rapha-gz-UC3M/Brazo_Robotico/README.md

# Brazo_Robotico
This is a repository for the fabrication of a Robotic Arm
