rapha-gz-UC3M/Brazo_Robotico/Gripper_Rapha/piezas_mm/README.md

# Piezas de Vasil y de Ignacio en mm

Copia exacta de `Arm_Vasil/Brazo_modificado_STL/*.stl` y `Base_Ignacio/*.stl` pasada a **mm**. Los originales
están en pulgadas (lo que exporta Solid Edge por defecto); aquí están multiplicados por 25,4. Tienen el mismo
nombre, la misma geometría y las mismas coordenadas, sin girar ni modificar nada.

Sirven para abrirlos, medirlos o montarlos en cualquier programa sin tener que escalar.
**Para imprimir, usa `imprimir_brazo/`**: ahí las piezas ya están orientadas y con los cambios necesarios.

Se regeneran con `python scripts/preparar_impresion.py` (por ejemplo, si Vasil o Ignacio cambian una pieza).
