rapha-gz-UC3M/Brazo_Robotico/Gripper_Rapha/base_sup_imprimible/montada.png

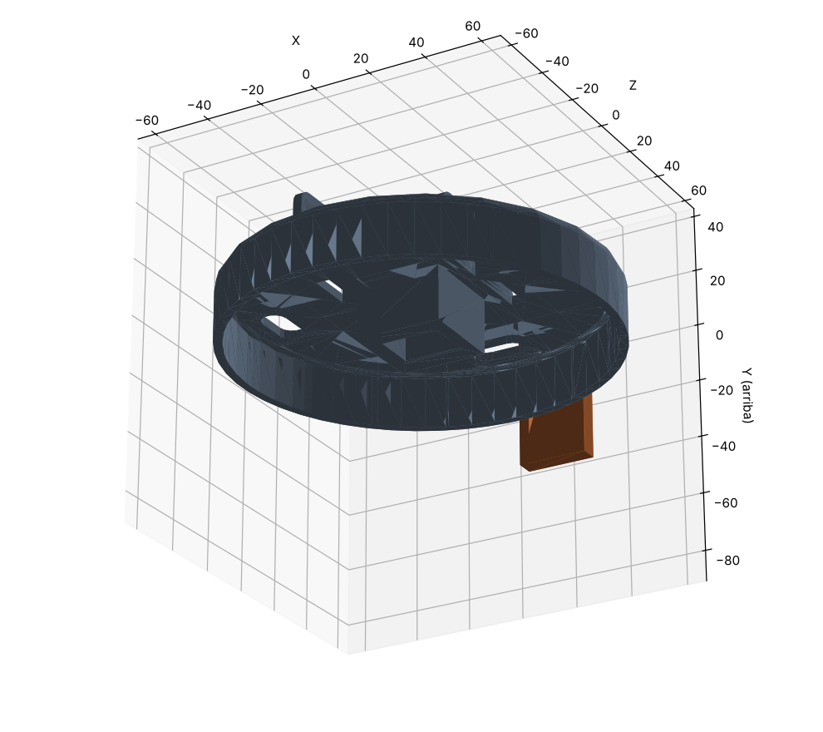
Gripper_Rapha/base_sup_imprimible/montada.png
