rapha-gz-UC3M/Brazo_Robotico/Gripper_Rapha/GRIPPER/imagenes/acople_punta_vistas.png

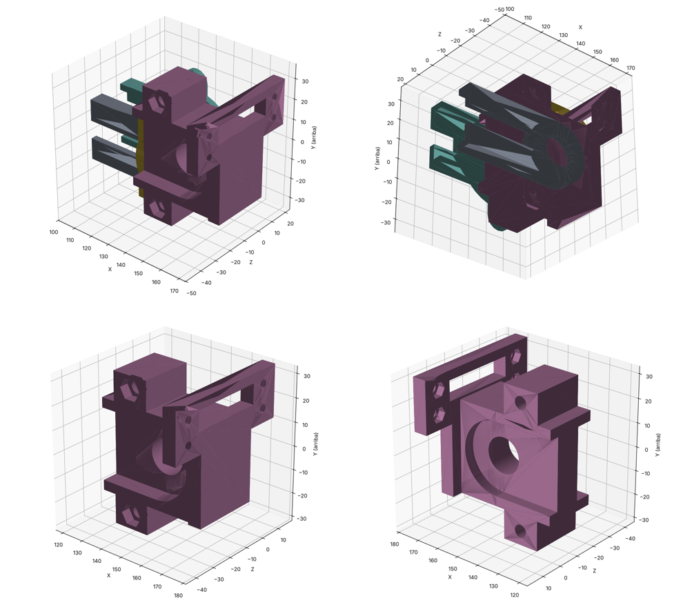
Gripper_Rapha/GRIPPER/imagenes/acople_punta_vistas.png
