rapha-gz-UC3M/Brazo_Robotico/Gripper_Rapha/imagenes/union_punta_detalle.png

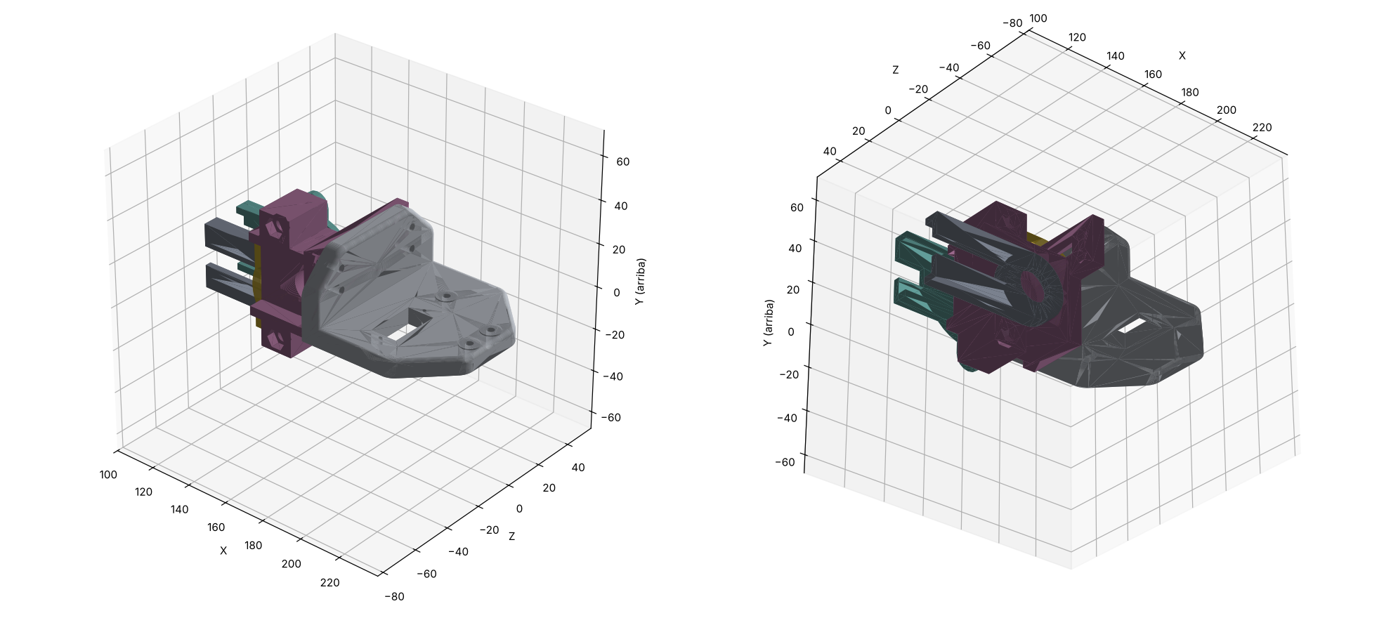
Gripper_Rapha/imagenes/union_punta_detalle.png
