rapha-gz-UC3M/Brazo_Robotico/Gripper_Rapha/comprobacion/ASM_gear_right.stl

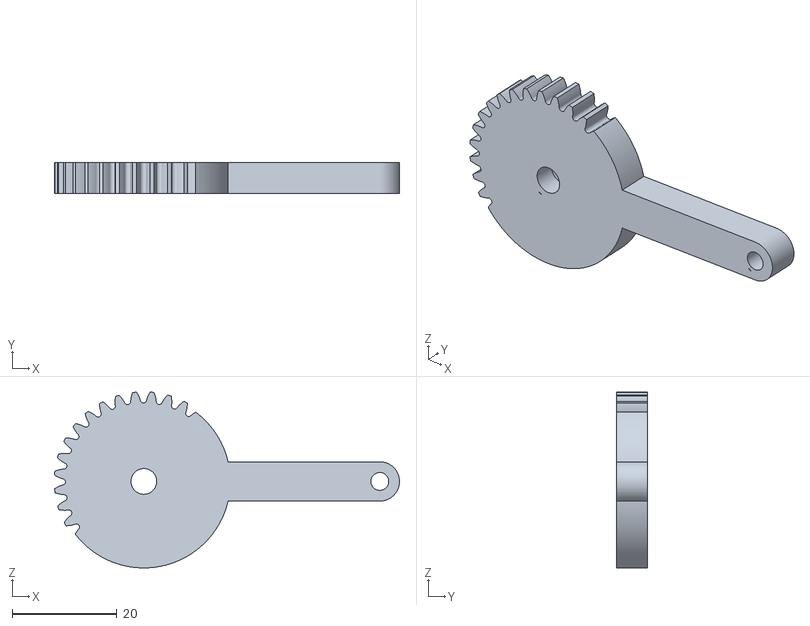
[picture p10: CAD file, 2026-10-21]
Gripper_Rapha/comprobacion/ASM_gear_right.stl
65.8 x 6.00 x 33.5
