rapha-gz-UC3M/Brazo_Robotico/Gripper_Rapha/Ensamblaje Garra - Chapa 3 agujeros.STL

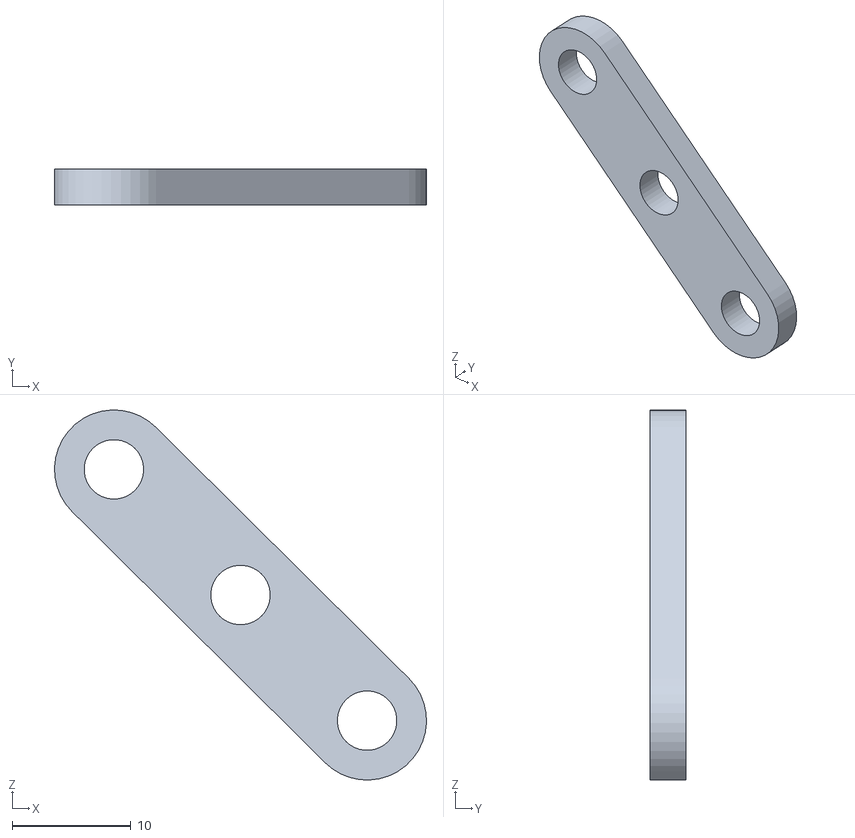
[picture p11: CAD file, 2026-10-06]
Gripper_Rapha/Ensamblaje Garra - Chapa 3 agujeros.STL
31.3 x 3.00 x 31.1
