rapha-gz-UC3M/Brazo_Robotico/Gripper_Rapha/ENSAMBLAJE/ensamblaje_brazo.stl

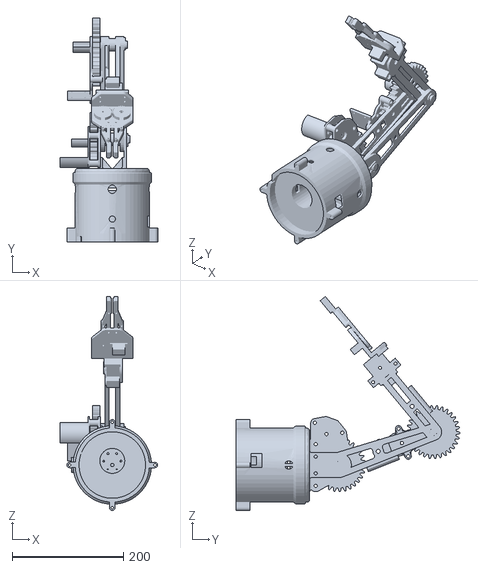
[picture p12: CAD file, 2026-10-24]
Gripper_Rapha/ENSAMBLAJE/ensamblaje_brazo.stl
175.3 x 402.9 x 384.7
