rapha-gz-UC3M/Brazo_Robotico/Gripper_Rapha/GRIPPER/comprobacion/ASM_arm_right.stl

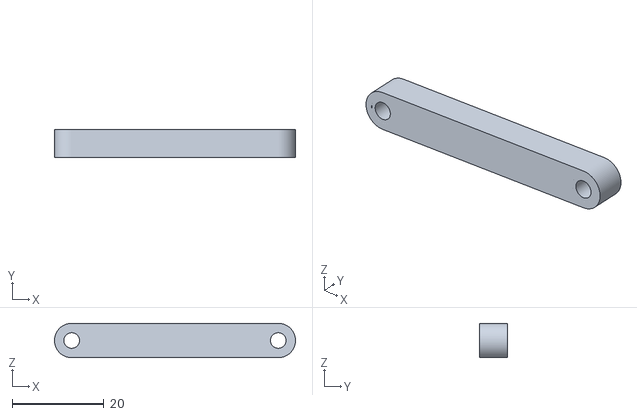
[picture p13: CAD file, 2026-10-24]
Gripper_Rapha/GRIPPER/comprobacion/ASM_arm_right.stl
52.5 x 6.00 x 7.50
