rapha-gz-UC3M/Brazo_Robotico/Gripper_Rapha/GRIPPER/solid_edge/Ensamblaje_Gripper_Brazo_Vasil/Ensamblaje_Gripper_Brazo_Vasil_x1.5.step

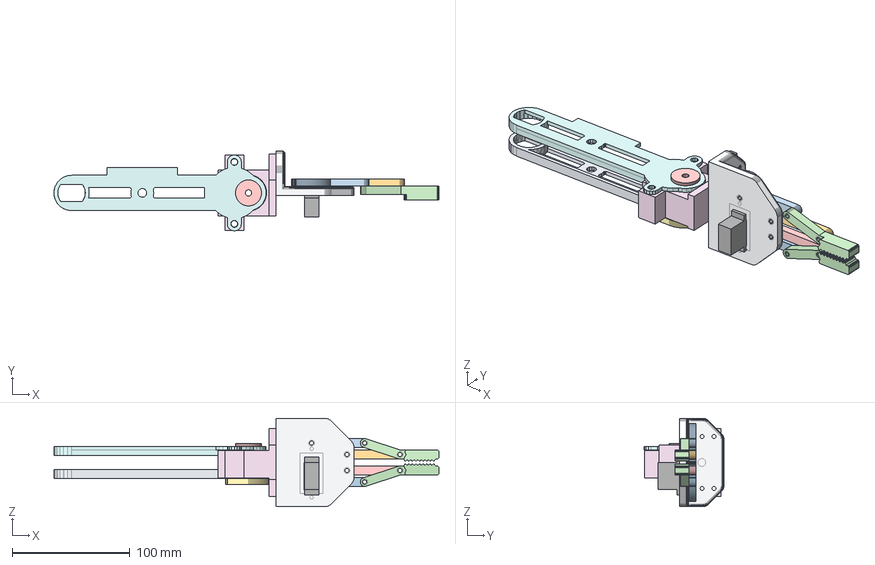
[picture p14: CAD file, 2026-10-24]
Gripper_Rapha/GRIPPER/solid_edge/Ensamblaje_Gripper_Brazo_Vasil/Ensamblaje_Gripper_Brazo_Vasil_x1.5.step
326.4 x 67.8 x 75.0 mm
Brazo_Parte_2_1_Vasil
Brazo_Parte_2.2_4_Vasil
Acople_punta_vasil_x1.5
Contraplaca_acople_x1.5
Casquillo_punta_x1.5
Gripper_base_plate_x1.5
Gripper_gear_left_x1.5
Gripper_gear_right_x1.5
Gripper_arm_left_x1.5
Gripper_arm_right_x1.5
Gripper_jaw_left_x1.5
Gripper_jaw_right_x1.5
Servo_MG90S_referencia
