rapha-gz-UC3M/Brazo_Robotico/Gripper_Rapha/solid_edge/Ensamblaje_Gripper_Antebrazo_Vasil_x1.5_STEP/Ensamblaje_Gripper_Antebrazo_Vasil_x1.5.step

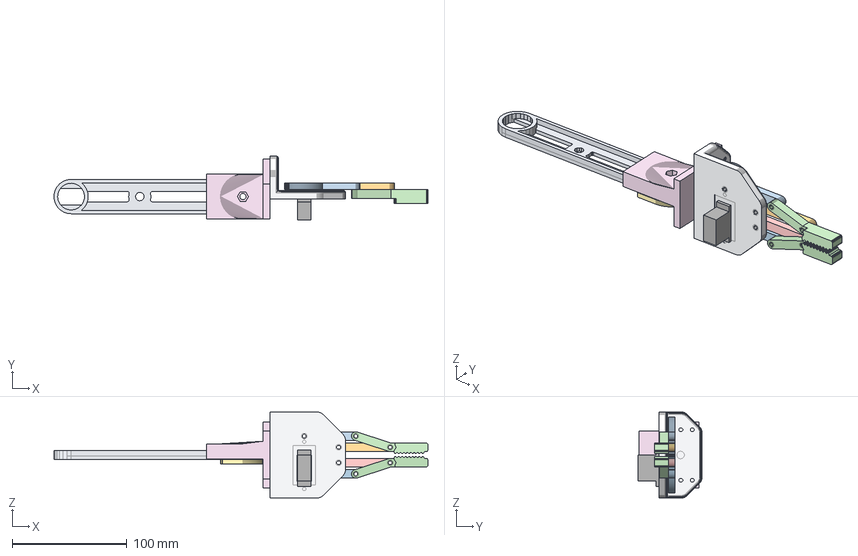
[picture p15: CAD file, 2026-10-20]
Gripper_Rapha/solid_edge/Ensamblaje_Gripper_Antebrazo_Vasil_x1.5_STEP/Ensamblaje_Gripper_Antebrazo_Vasil_x1.5.step
326.4 x 56.0 x 75.0 mm
REF_Brazo_Parte_2_1_Vasil
Acople_punta_vasil_x1.5
Contraplaca_acople_x1.5
Gripper_base_plate_x1.5
Gripper_gear_left_x1.5
Gripper_gear_right_x1.5
Gripper_arm_left_x1.5
Gripper_arm_right_x1.5
Gripper_jaw_left_x1.5
Gripper_jaw_right_x1.5
Servo_MG90S_referencia
