rapha-gz-UC3M/Brazo_Robotico/Gripper_Rapha/comprobacion/ASM_contraplaca_acople.stl

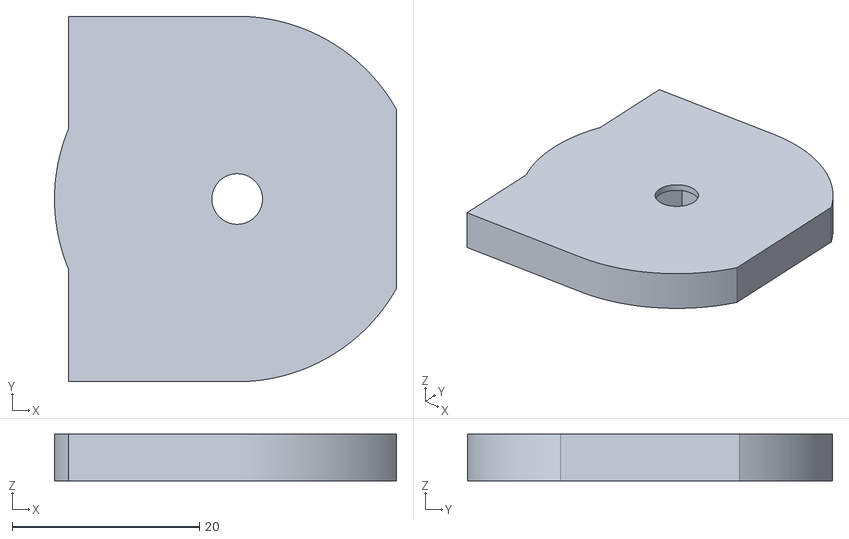
[picture p16: CAD file, 2026-10-21]
Gripper_Rapha/comprobacion/ASM_contraplaca_acople.stl
36.5 x 39.0 x 5.00
