rapha-gz-UC3M/Brazo_Robotico/Gripper_Rapha/Ensamblaje Garra - Chapa 2 agujeros.STL

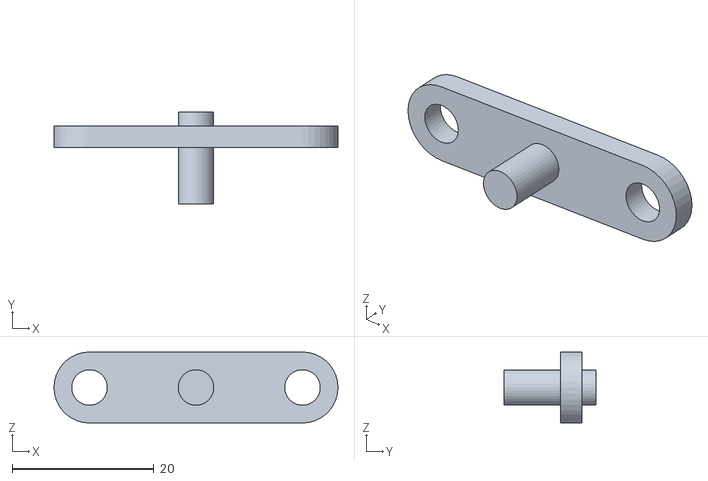
[picture p17: CAD file, 2026-10-06]
Gripper_Rapha/Ensamblaje Garra - Chapa 2 agujeros.STL
40.0 x 13.0 x 10.0
