rapha-gz-UC3M/Brazo_Robotico/Gripper_Rapha/ensamblaje_completo/ensamblaje_completo.stl

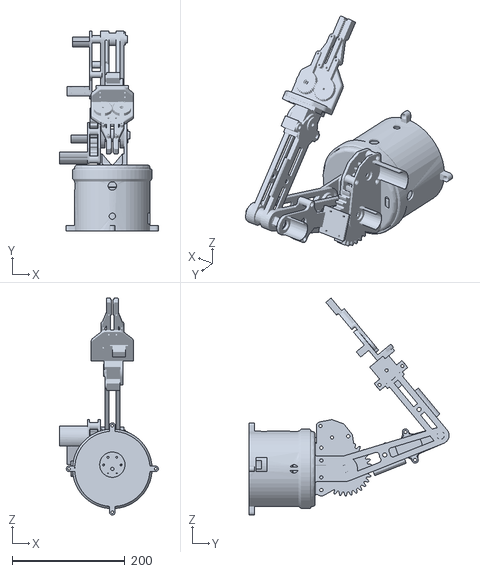
[picture p18: CAD file, 2026-10-21]
Gripper_Rapha/ensamblaje_completo/ensamblaje_completo.stl
175.3 x 354.9 x 384.7
