rapha-gz-UC3M/Brazo_Robotico/Gripper_Rapha/GRIPPER/comprobacion/ASM_casquillo_punta.stl

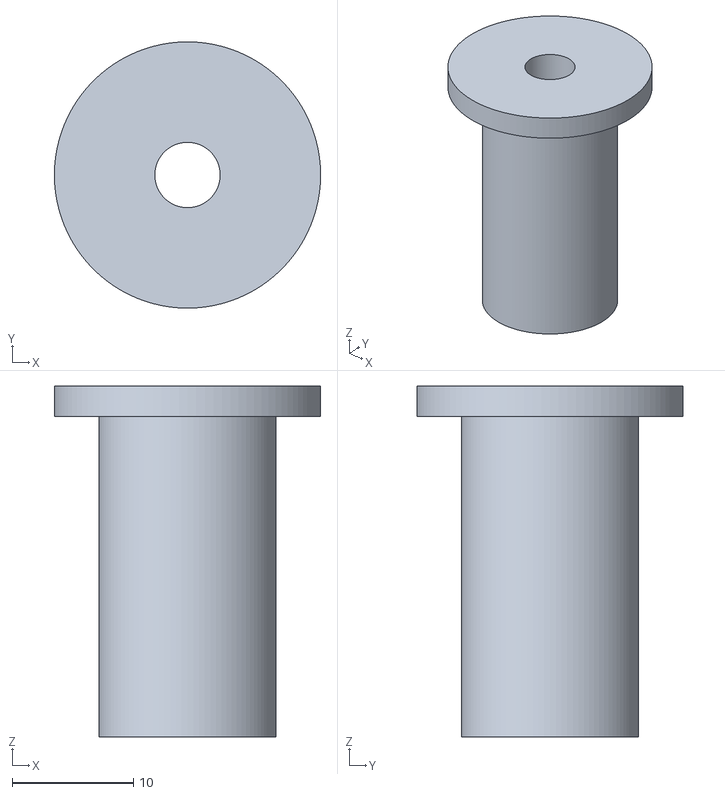
[picture p19: CAD file, 2026-10-24]
Gripper_Rapha/GRIPPER/comprobacion/ASM_casquillo_punta.stl
22.0 x 22.0 x 29.0
