rapha-gz-UC3M/Brazo_Robotico/Gripper_Rapha/Ensamblaje Garra - Cuerpo.STL

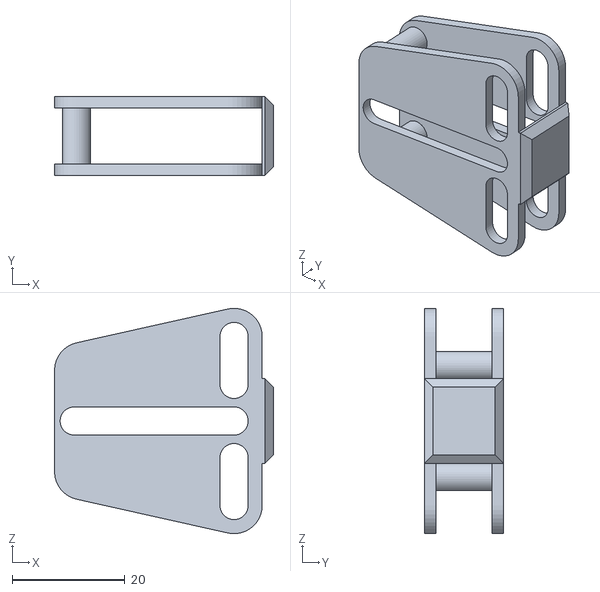
[picture p20: CAD file, 2026-10-06]
Gripper_Rapha/Ensamblaje Garra - Cuerpo.STL
38.9 x 14.0 x 40.0
