rapha-gz-UC3M/Brazo_Robotico/Gripper_Rapha/GRIPPER/comprobacion/ASM_servo_MG90S_aprox.stl

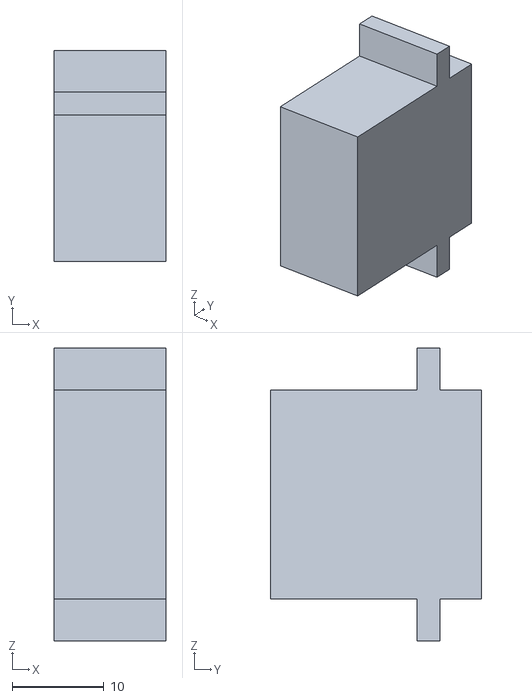
[picture p21: CAD file, 2026-10-24]
Gripper_Rapha/GRIPPER/comprobacion/ASM_servo_MG90S_aprox.stl
12.2 x 23.0 x 32.0
