rapha-gz-UC3M/Brazo_Robotico/Gripper_Rapha/comprobacion/ASM_jaw_right.stl

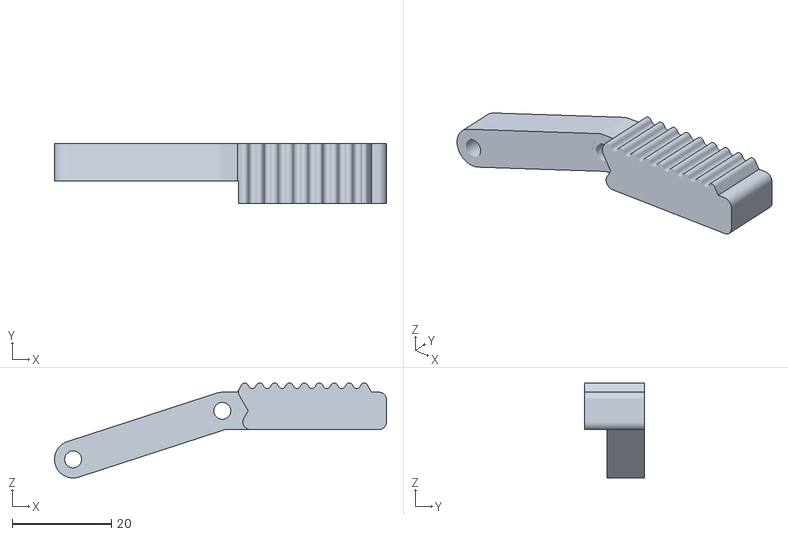
[picture p22: CAD file, 2026-10-21]
Gripper_Rapha/comprobacion/ASM_jaw_right.stl
66.7 x 12.0 x 19.1
