rapha-gz-UC3M/Brazo_Robotico/Gripper_Rapha/Ensamblaje Garra - Pinza.STL

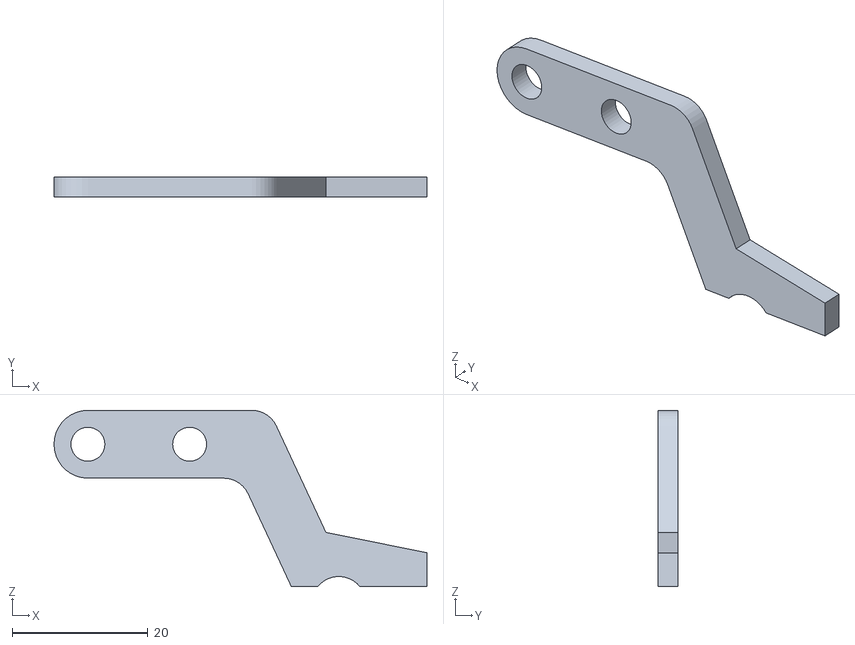
[picture p23: CAD file, 2026-10-06]
Gripper_Rapha/Ensamblaje Garra - Pinza.STL
55.0 x 3.00 x 26.0
