rapha-gz-UC3M/Brazo_Robotico/Gripper_Rapha/comprobacion/ASM_base_plate.stl

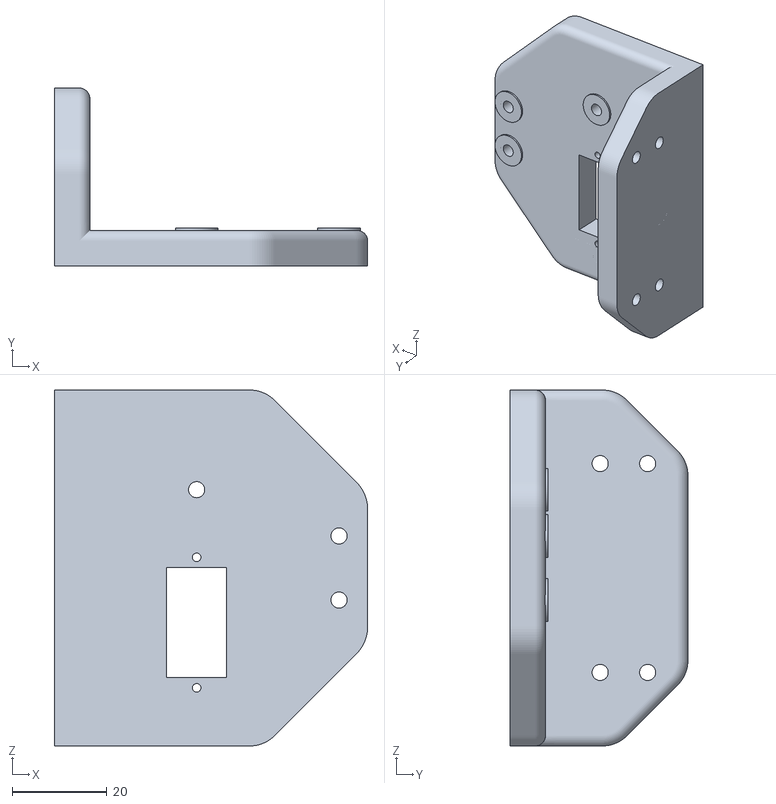
[picture p24: CAD file, 2026-10-21]
Gripper_Rapha/comprobacion/ASM_base_plate.stl
66.0 x 37.5 x 75.0
