rapha-gz-UC3M/Brazo_Robotico/Gripper_Rapha/GRIPPER/comprobacion/ASM_acople_punta_vasil.stl

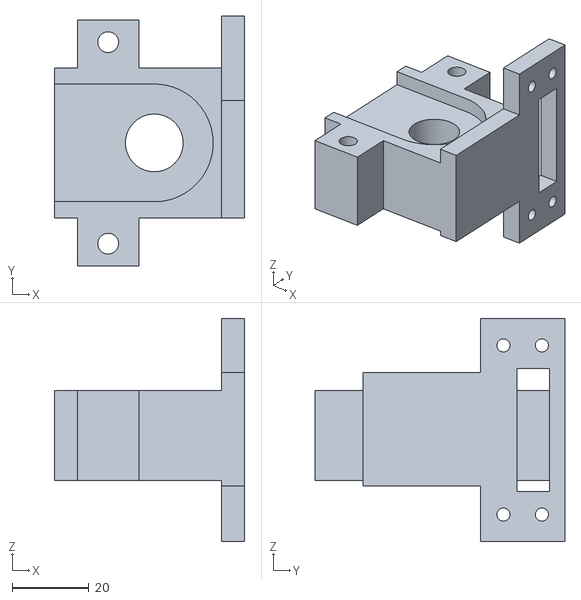
[picture p25: CAD file, 2026-10-24]
Gripper_Rapha/GRIPPER/comprobacion/ASM_acople_punta_vasil.stl
49.5 x 65.0 x 58.0
