rapha-gz-UC3M/Brazo_Robotico/Arm_Vasil/Brazo_modificado_STL/Brazo Parte 2.2_4.stl

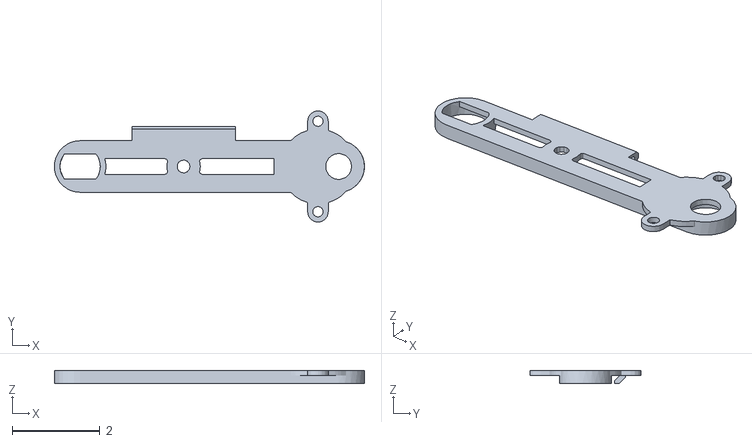
[picture p26: CAD file, 2026-10-21]
Arm_Vasil/Brazo_modificado_STL/Brazo Parte 2.2_4.stl
7.08 x 2.54 x 0.295
