rapha-gz-UC3M/Brazo_Robotico/Base_Ignacio/BASE_TAPA_INF.stl

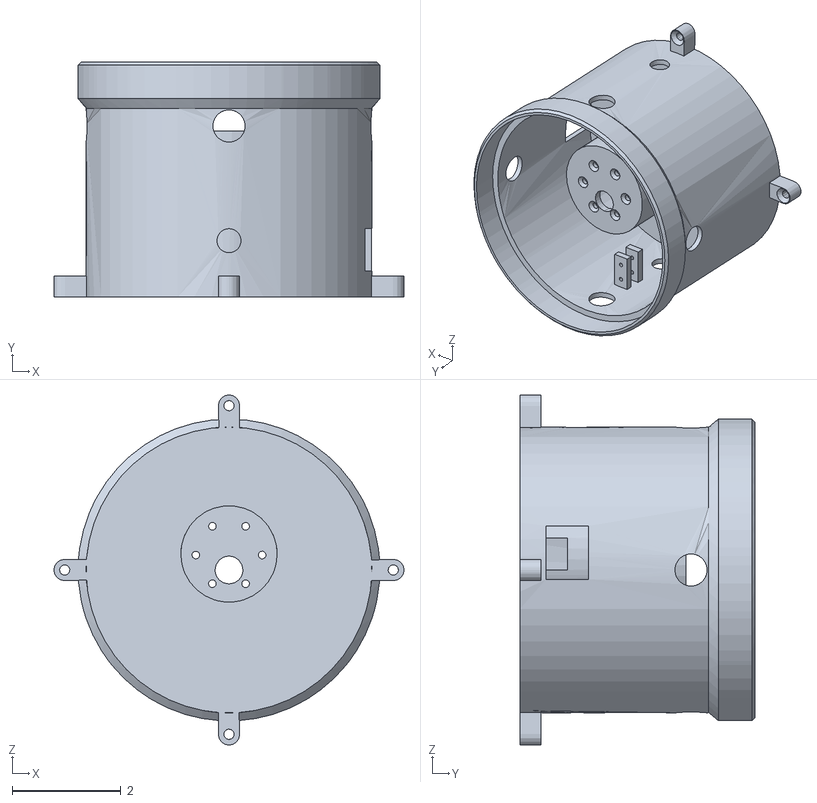
[picture p27: CAD file, 2026-10-17]
Base_Ignacio/BASE_TAPA_INF.stl
6.44 x 4.33 x 6.44
