rapha-gz-UC3M/Brazo_Robotico/Base_Igni/BR3E - Base Tapa Inferior.STL

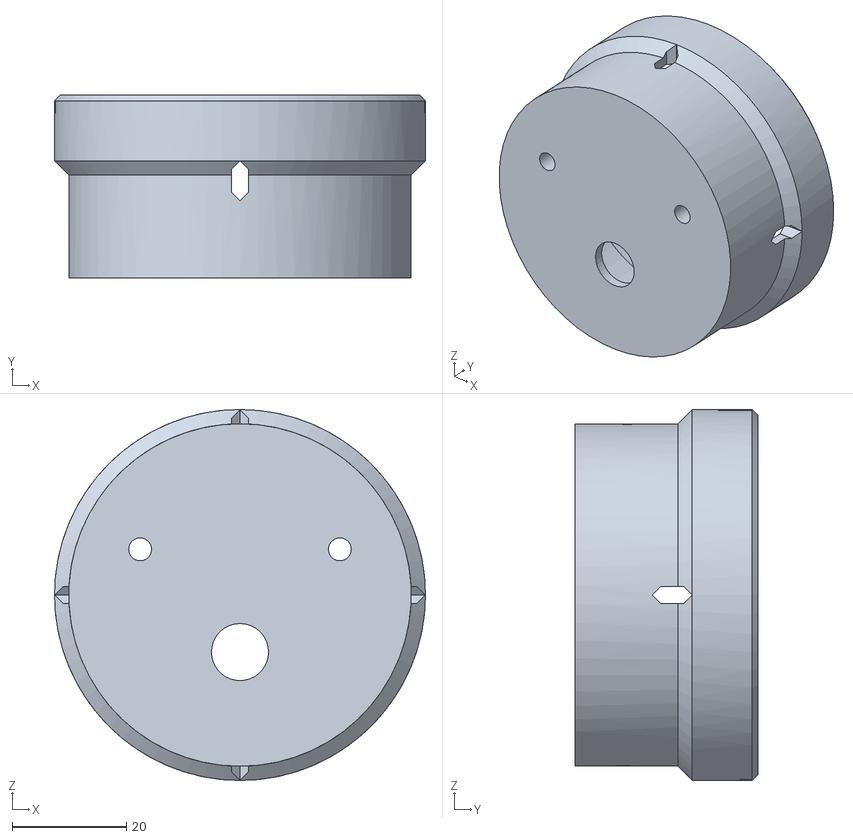
[picture p28: CAD file, 2026-10-06]
Base_Igni/BR3E - Base Tapa Inferior.STL
65.0 x 32.0 x 65.0
