rapha-gz-UC3M/Brazo_Robotico/Brazo_Vasil/BR3E - Sujetador de eje.STL

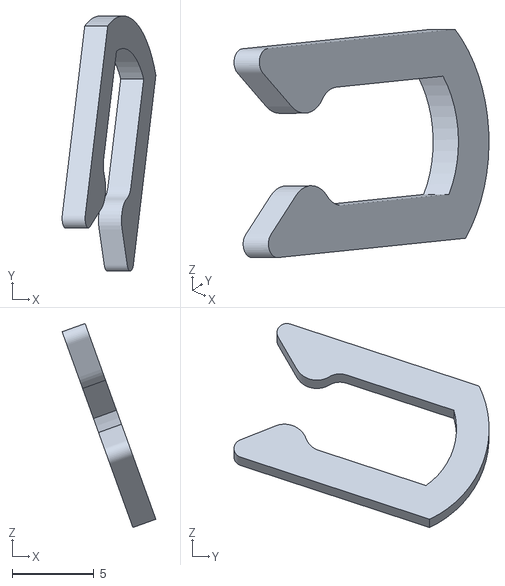
[picture p29: CAD file, 2026-10-06]
Brazo_Vasil/BR3E - Sujetador de eje.STL
5.75 x 15.6 x 12.5
