rapha-gz-UC3M/Brazo_Robotico/Gripper_Rapha/base_sup_imprimible/BASE_TAPA_SUP_pestana.stl

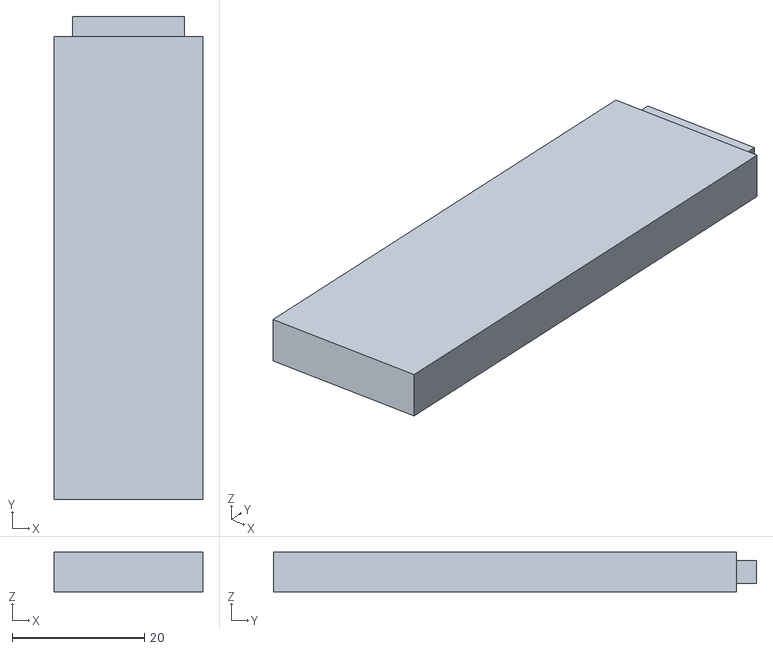
[picture p30: CAD file, 2026-10-21]
Gripper_Rapha/base_sup_imprimible/BASE_TAPA_SUP_pestana.stl
22.5 x 73.0 x 6.00
