rapha-gz-UC3M/Brazo_Robotico/Gripper_Rapha/ENSAMBLAJE/piezas_colocadas/Brazo_Parte_1_1.stl

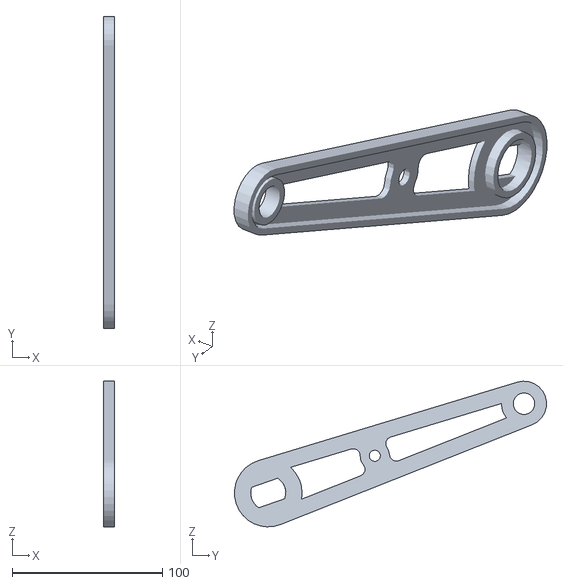
[picture p31: CAD file, 2026-10-24]
Gripper_Rapha/ENSAMBLAJE/piezas_colocadas/Brazo_Parte_1_1.stl
7.50 x 207.3 x 96.8
