rapha-gz-UC3M/Brazo_Robotico/Gripper_Rapha/ensamblaje_completo/motores_JGB37_referencia.stl

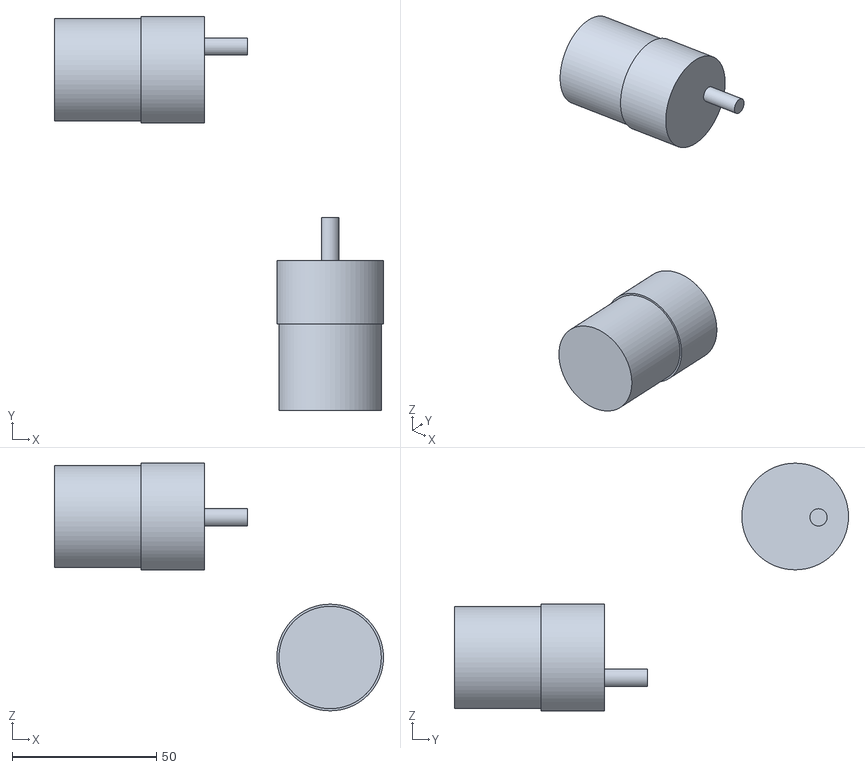
[picture p32: CAD file, 2026-10-21]
Gripper_Rapha/ensamblaje_completo/motores_JGB37_referencia.stl
114.1 x 136.7 x 85.9
