rapha-gz-UC3M/Brazo_Robotico/Gripper_Rapha/ensamblaje_completo/piezas_colocadas/Vasil_Pinon_hombro.stl

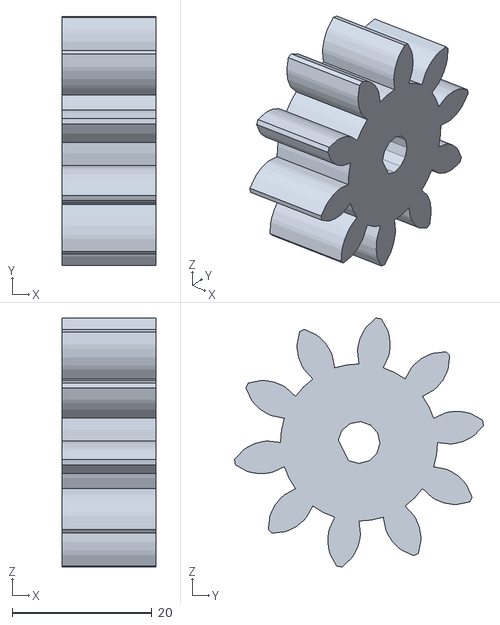
[picture p33: CAD file, 2026-10-21]
Gripper_Rapha/ensamblaje_completo/piezas_colocadas/Vasil_Pinon_hombro.stl
13.5 x 35.7 x 35.7
