rapha-gz-UC3M/Brazo_Robotico/Gripper_Rapha/GRIPPER/original/gripper_superbtech/base_plate.stl

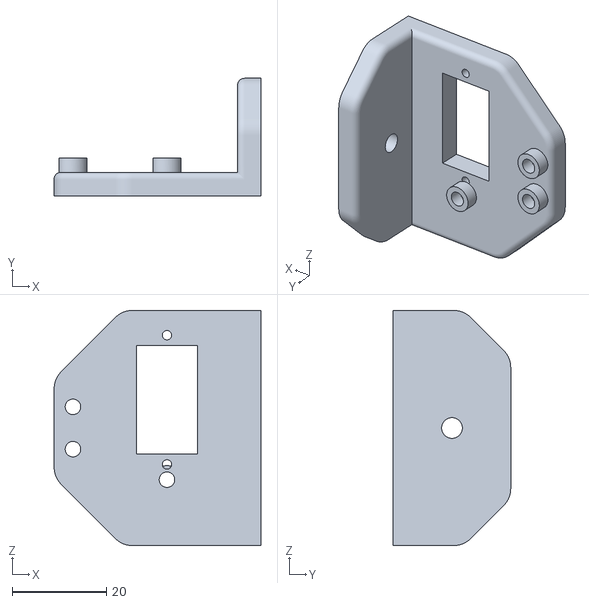
[picture p34: CAD file, 2026-10-24]
Gripper_Rapha/GRIPPER/original/gripper_superbtech/base_plate.stl
44.0 x 25.0 x 50.0
