rapha-gz-UC3M/Brazo_Robotico/Gripper_Rapha/IMPRIMIR/1_base/Pieza_Eje_Giro_Base.stl

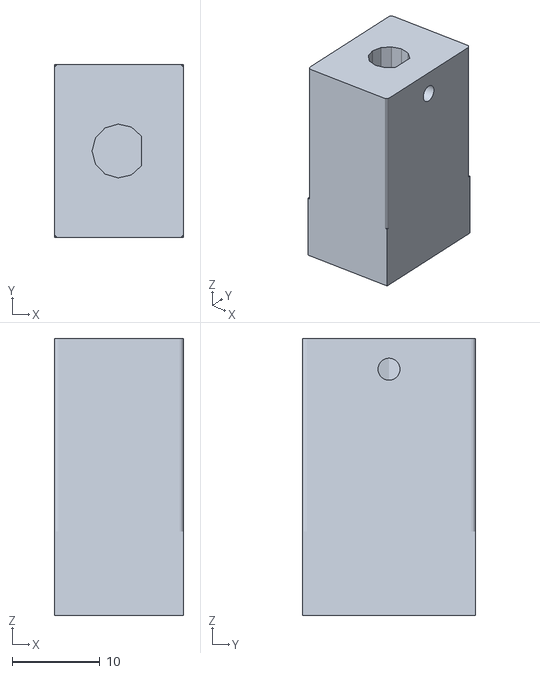
[picture p35: CAD file, 2026-10-24]
Gripper_Rapha/IMPRIMIR/1_base/Pieza_Eje_Giro_Base.stl
14.8 x 19.8 x 31.6
