rapha-gz-UC3M/Brazo_Robotico/Gripper_Rapha/IMPRIMIR/2_brazo/Sujetador_de_eje_x2.stl

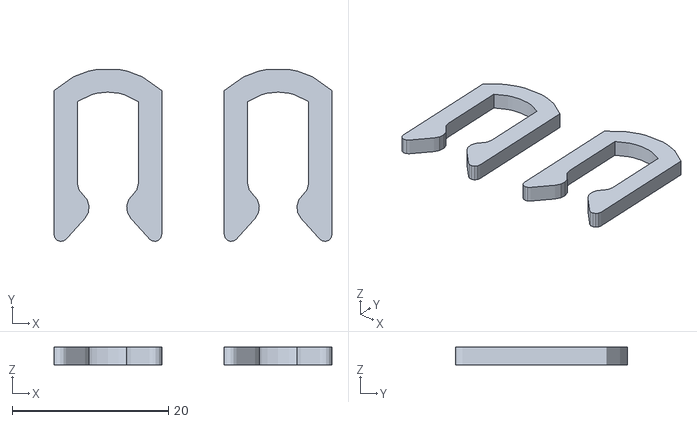
[picture p36: CAD file, 2026-10-24]
Gripper_Rapha/IMPRIMIR/2_brazo/Sujetador_de_eje_x2.stl
35.6 x 22.0 x 2.25
