rapha-gz-UC3M/Brazo_Robotico/Gripper_Rapha/imprimir_brazo/2_brazo_Vasil/Shield_2_imprimible.stl

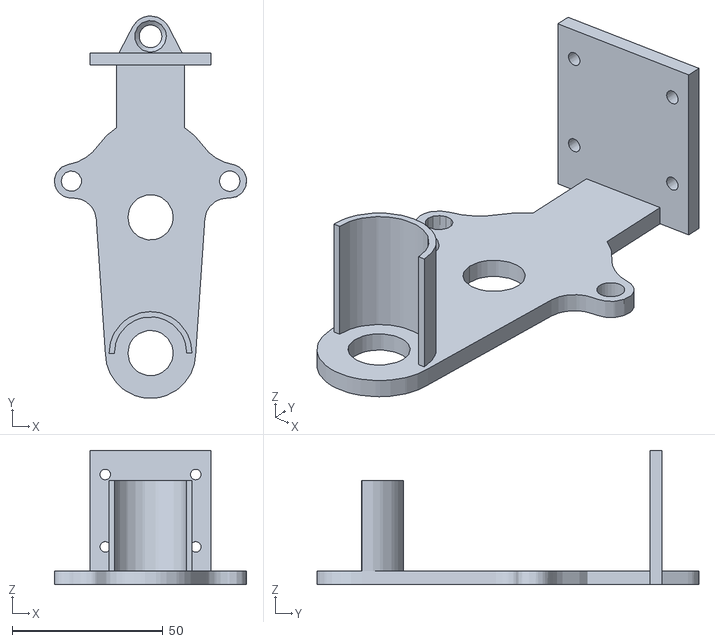
[picture p37: CAD file, 2026-10-21]
Gripper_Rapha/imprimir_brazo/2_brazo_Vasil/Shield_2_imprimible.stl
63.7 x 126.6 x 44.5
