rapha-gz-UC3M/Brazo_Robotico/Gripper_Rapha/original/gripper_superbtech/jaw_left.stl

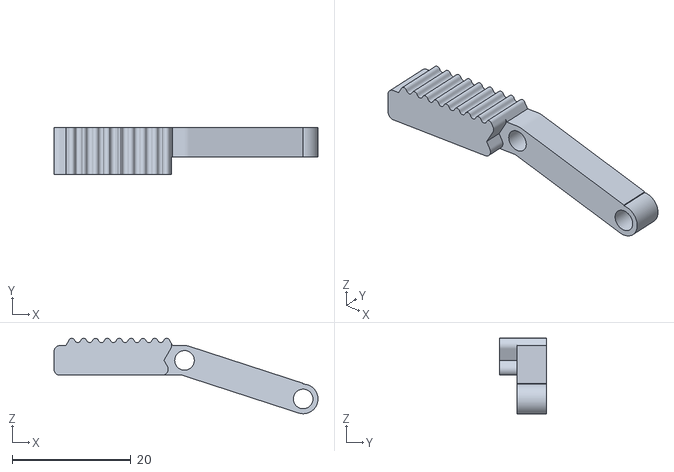
[picture p38: CAD file, 2026-10-18]
Gripper_Rapha/original/gripper_superbtech/jaw_left.stl
44.5 x 8.00 x 12.7
