rapha-gz-UC3M/Brazo_Robotico/Gripper_Rapha/piezas_mm/Arm_Vasil/Shield 1 - 2.0_1.stl

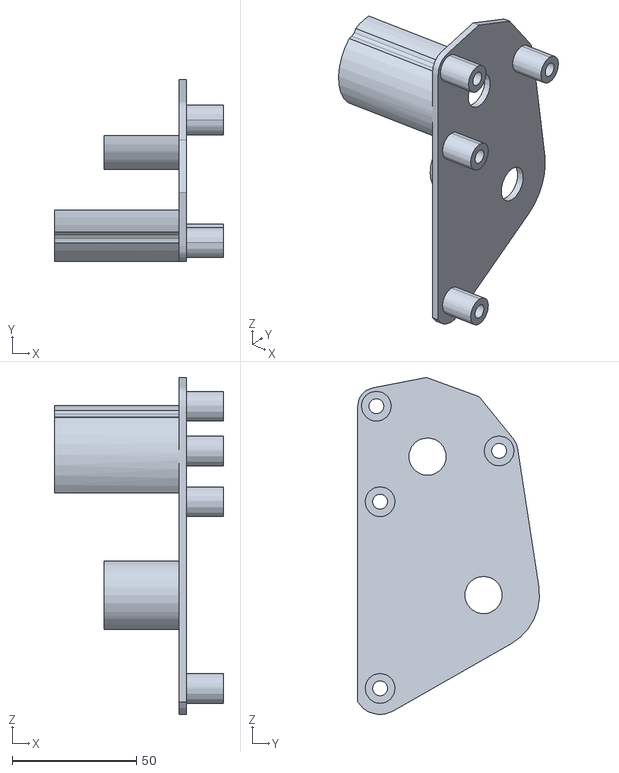
[picture p39: CAD file, 2026-10-21]
Gripper_Rapha/piezas_mm/Arm_Vasil/Shield 1 - 2.0_1.stl
68.0 x 73.1 x 135.4
