rapha-gz-UC3M/Brazo_Robotico/Gripper_Rapha/piezas_mm/Base_Ignacio/BASE_TAPA_SUP.stl

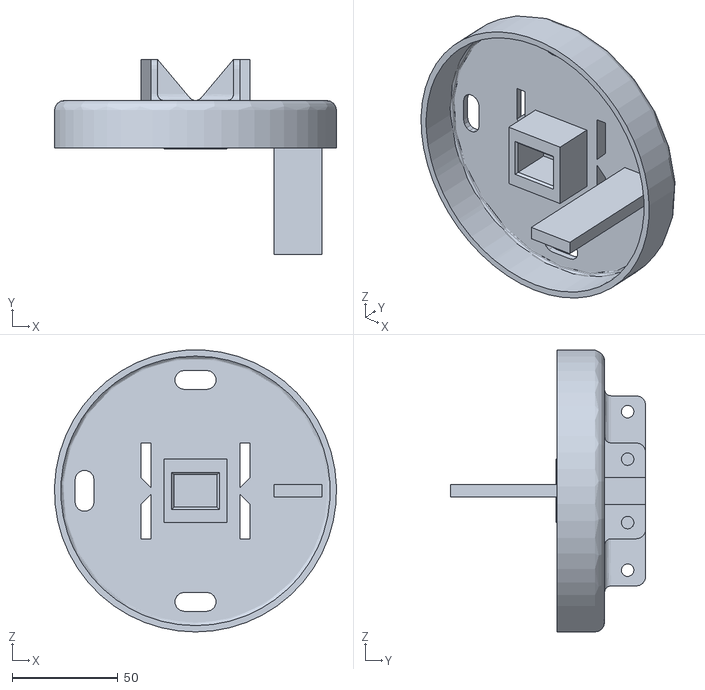
[picture p40: CAD file, 2026-10-21]
Gripper_Rapha/piezas_mm/Base_Ignacio/BASE_TAPA_SUP.stl
133.4 x 92.5 x 133.4
