rapha-gz-UC3M/Brazo_Robotico/Gripper_Rapha/shields_imprimibles/comprobacion/Shield_1_placa_posicion_montaje.stl

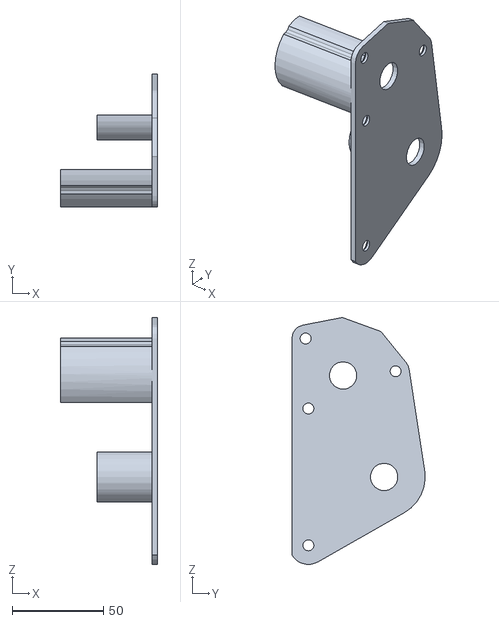
[picture p41: CAD file, 2026-10-21]
Gripper_Rapha/shields_imprimibles/comprobacion/Shield_1_placa_posicion_montaje.stl
53.0 x 73.1 x 135.4
