rapha-gz-UC3M/Brazo_Robotico/Gripper_Rapha/shields_imprimibles/Shield_2_separadores_x3.stl

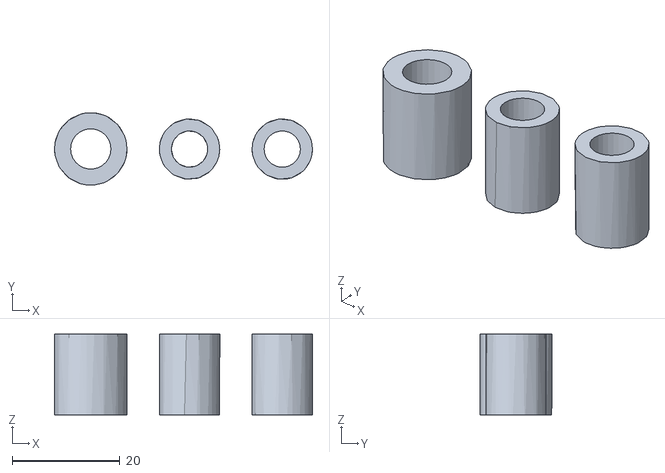
[picture p42: CAD file, 2026-10-21]
Gripper_Rapha/shields_imprimibles/Shield_2_separadores_x3.stl
48.0 x 13.5 x 15.0
