rapha-gz-UC3M/Brazo_Robotico/Arm_Vasil/Brazo_modificado_STL/Shield 1 - 2.0_1.stl

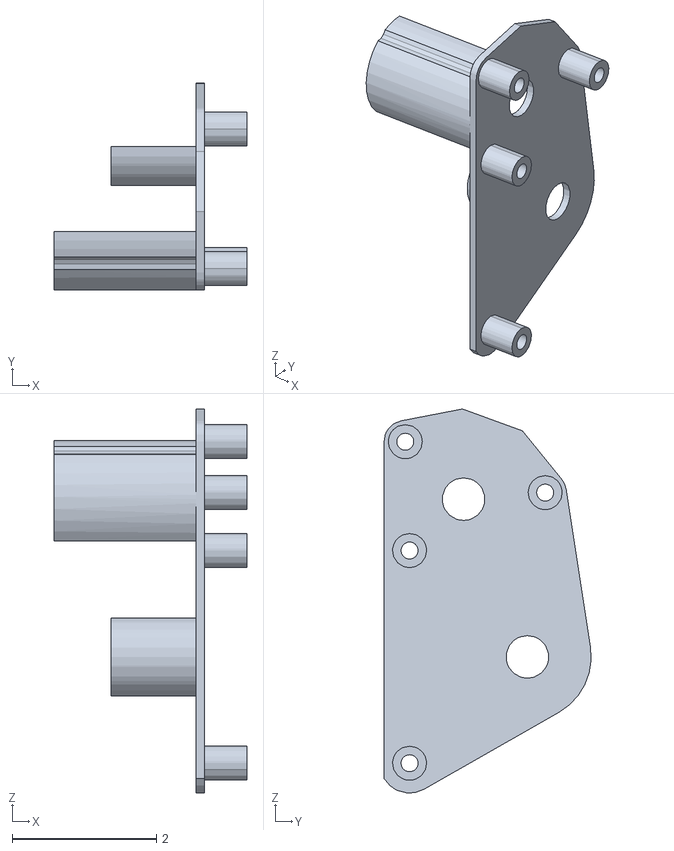
[picture p43: CAD file, 2026-10-21]
Arm_Vasil/Brazo_modificado_STL/Shield 1 - 2.0_1.stl
2.68 x 2.88 x 5.33
