rapha-gz-UC3M/Brazo_Robotico/Base_Ignacio/BASE_TAPA_SUP.stl

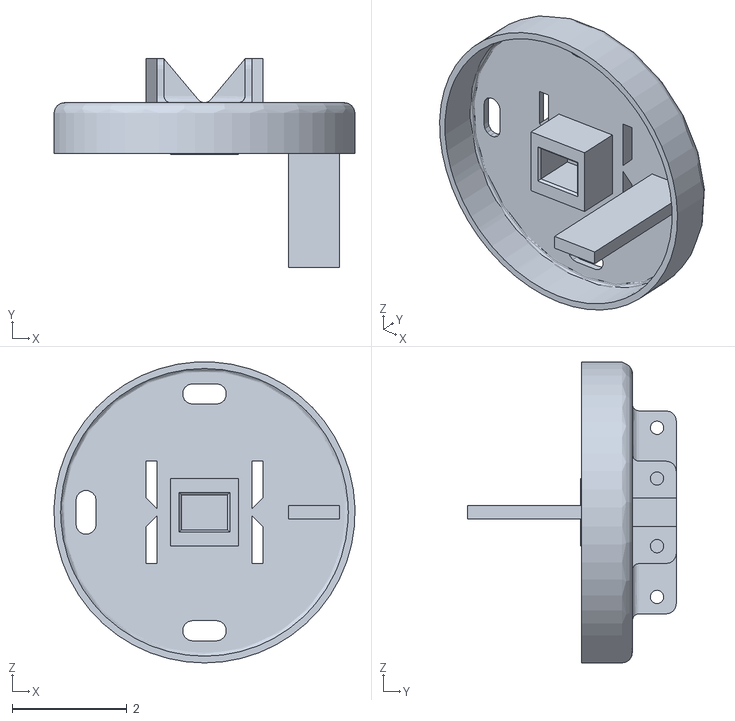
[picture p44: CAD file, 2026-10-17]
Base_Ignacio/BASE_TAPA_SUP.stl
5.25 x 3.64 x 5.25
