rapha-gz-UC3M/Brazo_Robotico/Base_Igni/BR3E - Base Tapa Superior - Entera.STL

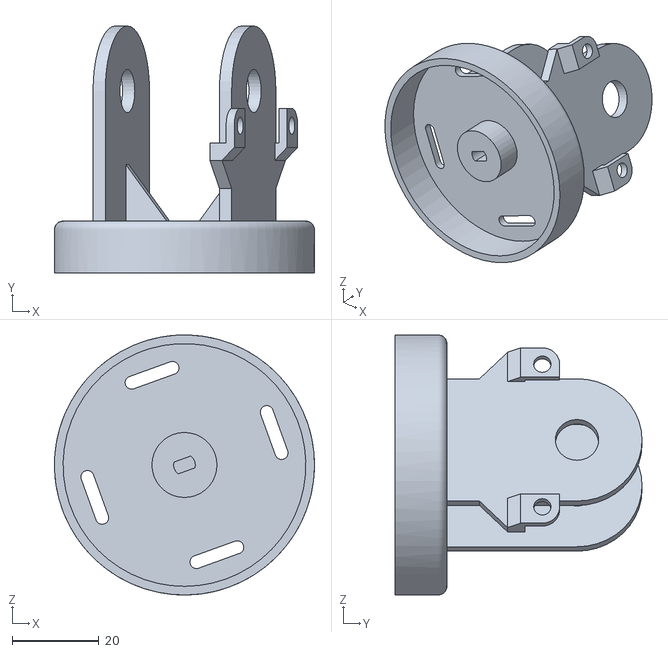
[picture p45: CAD file, 2026-10-06]
Base_Igni/BR3E - Base Tapa Superior - Entera.STL
60.0 x 57.0 x 60.0
