rapha-gz-UC3M/Brazo_Robotico/Brazo_Vasil/BR3E - Brazo Parte 1.STL

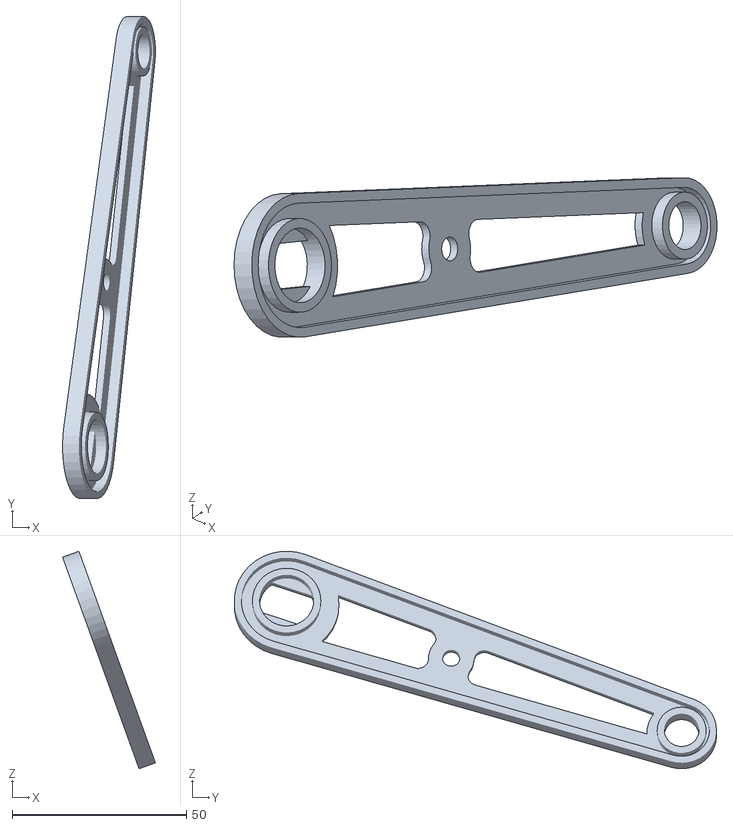
[picture p46: CAD file, 2026-10-06]
Brazo_Vasil/BR3E - Brazo Parte 1.STL
26.6 x 138.2 x 62.4
