rapha-gz-UC3M/Brazo_Robotico/Gripper_Rapha/base_sup_imprimible/BASE_TAPA_SUP_imprimible.stl

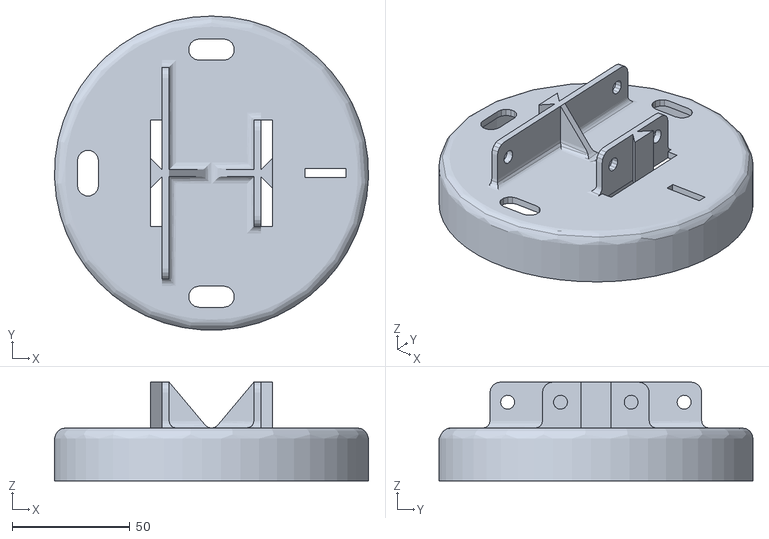
[picture p47: CAD file, 2026-10-21]
Gripper_Rapha/base_sup_imprimible/BASE_TAPA_SUP_imprimible.stl
133.4 x 133.4 x 42.0
