rapha-gz-UC3M/Brazo_Robotico/Gripper_Rapha/ENSAMBLAJE/motores_JGB37_referencia.stl

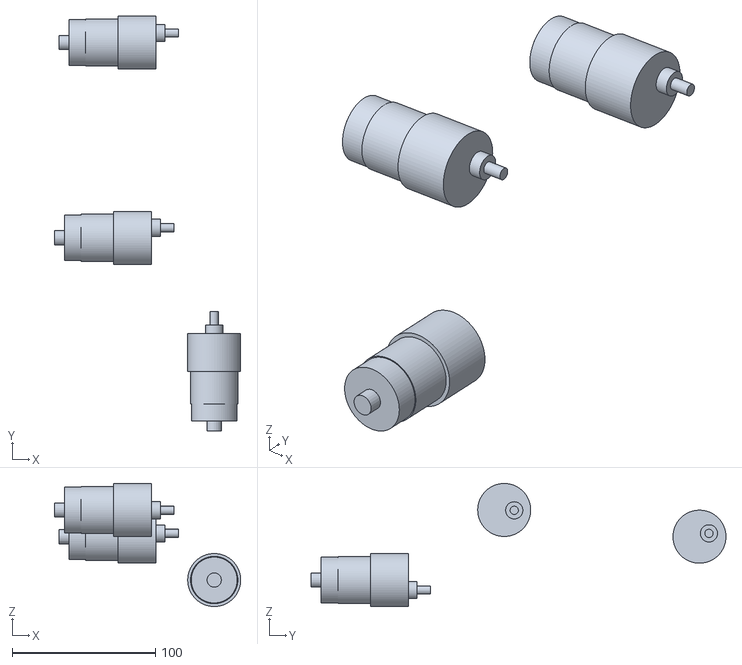
[picture p48: CAD file, 2026-10-24]
Gripper_Rapha/ENSAMBLAJE/motores_JGB37_referencia.stl
130.1 x 289.4 x 85.9
