rapha-gz-UC3M/Brazo_Robotico/Gripper_Rapha/ENSAMBLAJE/piezas_colocadas/Sujetador_hombro.stl

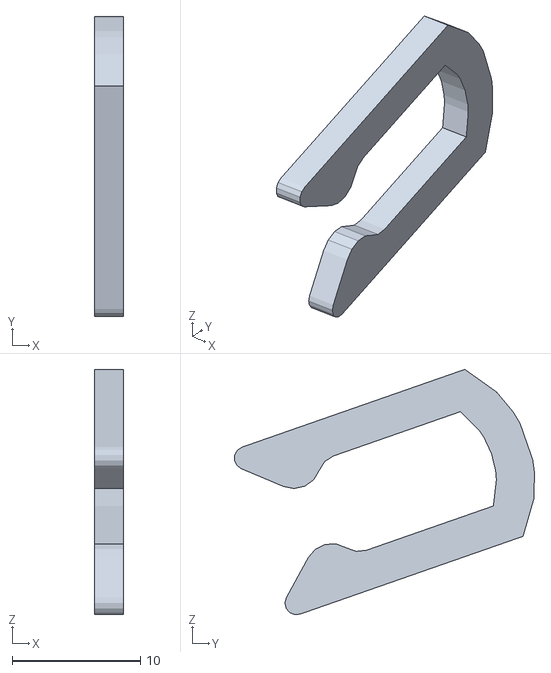
[picture p49: CAD file, 2026-10-24]
Gripper_Rapha/ENSAMBLAJE/piezas_colocadas/Sujetador_hombro.stl
2.25 x 23.4 x 19.1
