rapha-gz-UC3M/Brazo_Robotico/Gripper_Rapha/ensamblaje_completo/piezas_colocadas/Vasil_Eje_Parte_1.stl

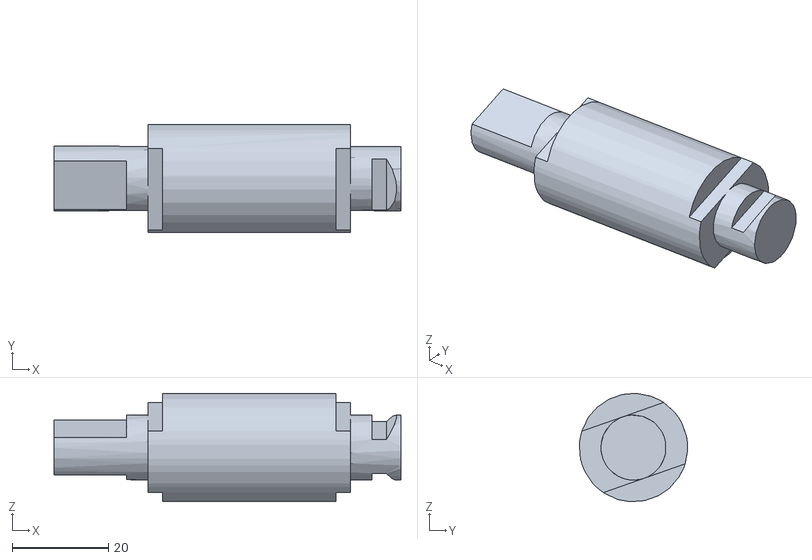
[picture p50: CAD file, 2026-10-21]
Gripper_Rapha/ensamblaje_completo/piezas_colocadas/Vasil_Eje_Parte_1.stl
72.0 x 22.5 x 22.5
