rapha-gz-UC3M/Brazo_Robotico/Gripper_Rapha/IMPRIMIR/1_base/BASE_TAPA_INF.stl

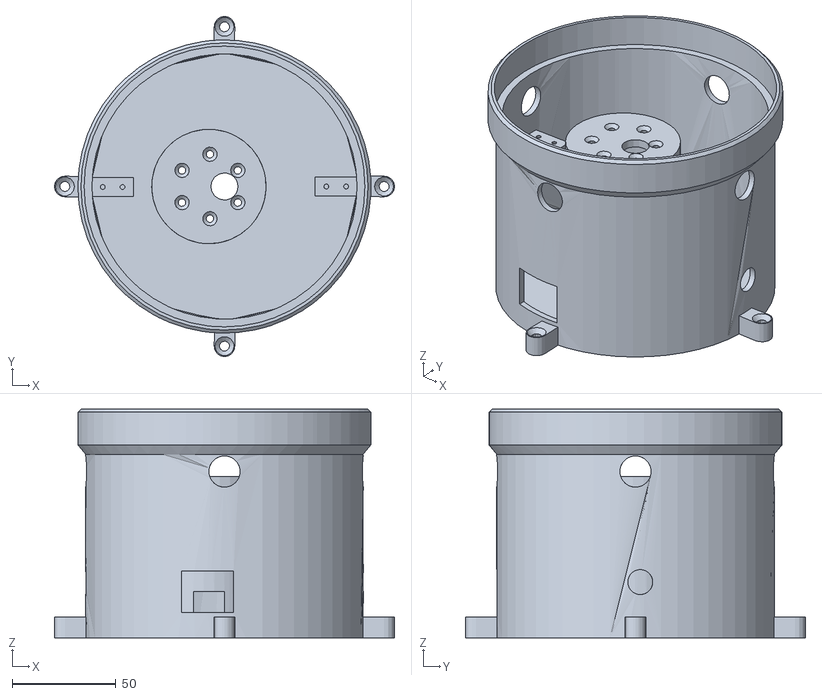
[picture p51: CAD file, 2026-10-24]
Gripper_Rapha/IMPRIMIR/1_base/BASE_TAPA_INF.stl
163.5 x 163.5 x 110.0
