rapha-gz-UC3M/Brazo_Robotico/Gripper_Rapha/IMPRIMIR/2_brazo/Corona_30_dientes_x2.stl

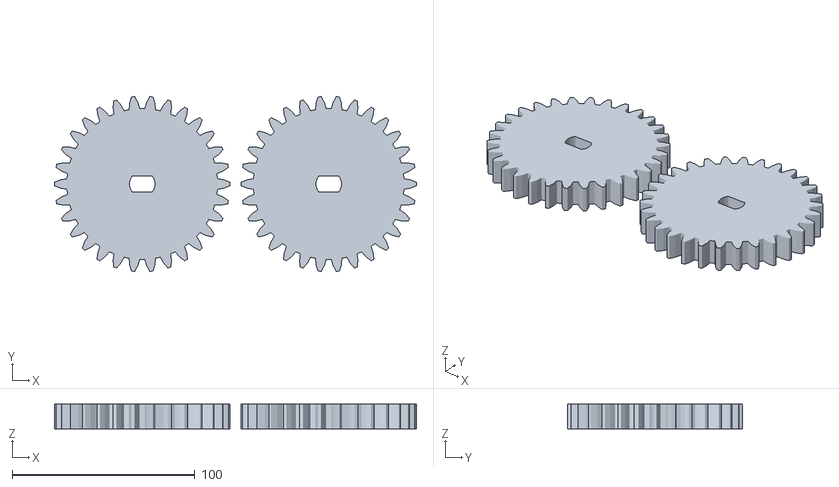
[picture p52: CAD file, 2026-10-24]
Gripper_Rapha/IMPRIMIR/2_brazo/Corona_30_dientes_x2.stl
198.0 x 95.6 x 13.5
