rapha-gz-UC3M/Brazo_Robotico/Gripper_Rapha/imprimir_brazo/2_brazo_Vasil/Pinon_10_dientes_modulo_3_agujero_D_6.15.stl

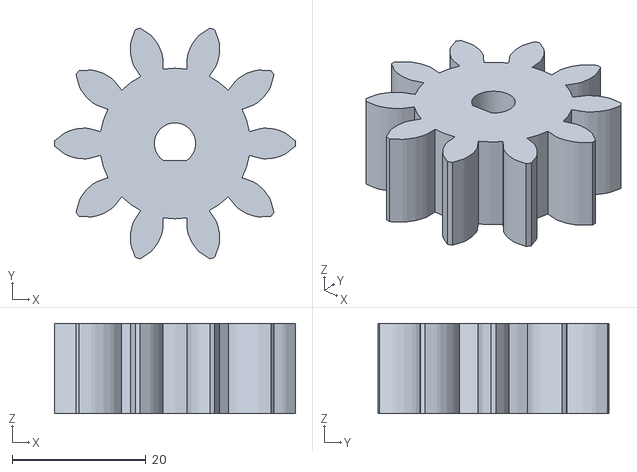
[picture p53: CAD file, 2026-10-21]
Gripper_Rapha/imprimir_brazo/2_brazo_Vasil/Pinon_10_dientes_modulo_3_agujero_D_6.15.stl
36.0 x 34.5 x 13.5
