rapha-gz-UC3M/Brazo_Robotico/Gripper_Rapha/piezas_mm/Arm_Vasil/Eje Parte 3_1.stl

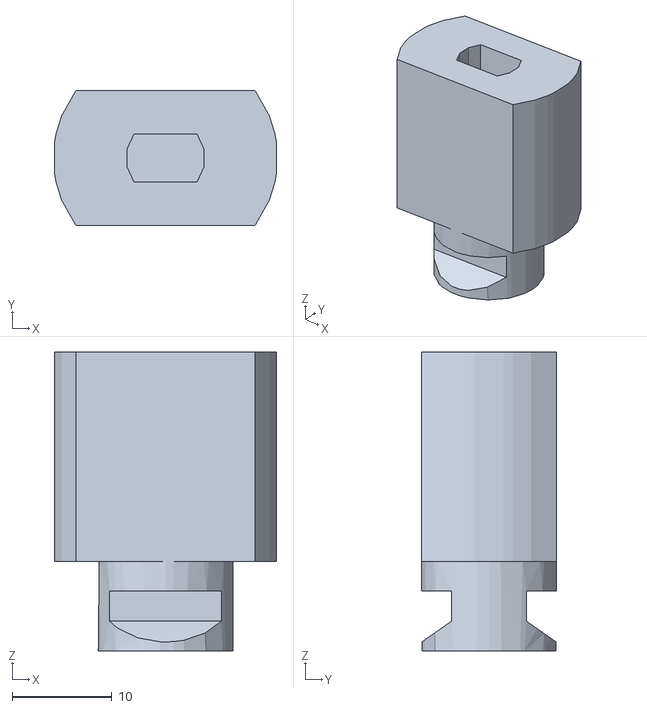
[picture p54: CAD file, 2026-10-21]
Gripper_Rapha/piezas_mm/Arm_Vasil/Eje Parte 3_1.stl
22.3 x 13.5 x 30.0
