rapha-gz-UC3M/Brazo_Robotico/Gripper_Rapha/piezas_mm/Base_Ignacio/Pieza_Eje_Giro_Base.stl

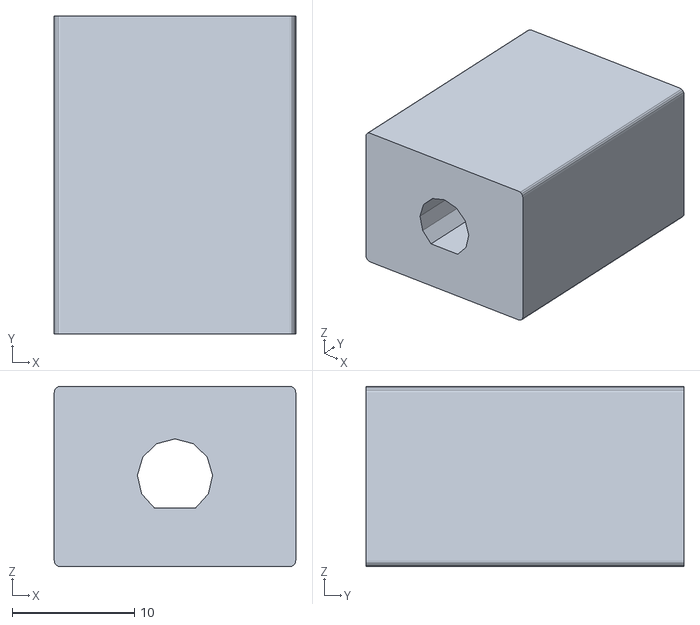
[picture p55: CAD file, 2026-10-21]
Gripper_Rapha/piezas_mm/Base_Ignacio/Pieza_Eje_Giro_Base.stl
19.8 x 26.0 x 14.8
