rapha-gz-UC3M/Brazo_Robotico/Gripper_Rapha/shields_imprimibles/Shield_1_separadores_x4.stl

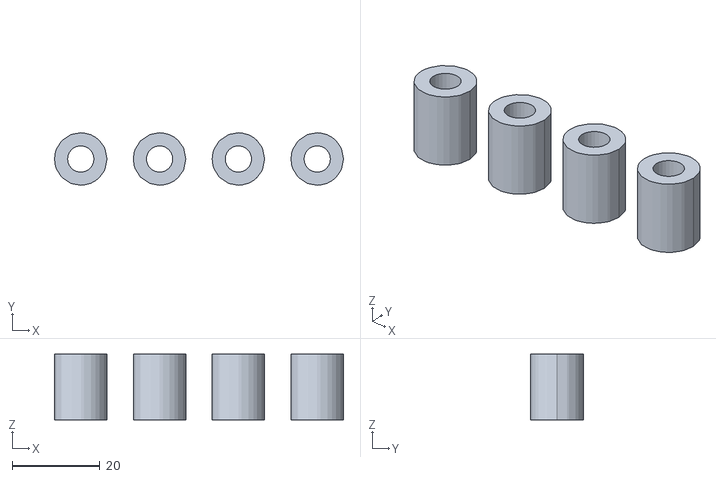
[picture p56: CAD file, 2026-10-21]
Gripper_Rapha/shields_imprimibles/Shield_1_separadores_x4.stl
66.0 x 12.0 x 15.0
