rapha-gz-UC3M/Brazo_Robotico/Arm_Vasil/Brazo_modificado_STL/Brazo Parte 1_1.stl

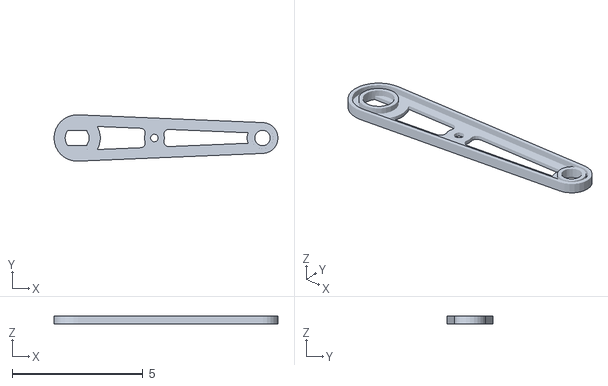
[picture p57: CAD file, 2026-10-21]
Arm_Vasil/Brazo_modificado_STL/Brazo Parte 1_1.stl
8.56 x 1.77 x 0.295
