rapha-gz-UC3M/Brazo_Robotico/Base_Ignacio/Pieza_Eje_Giro_Base.stl

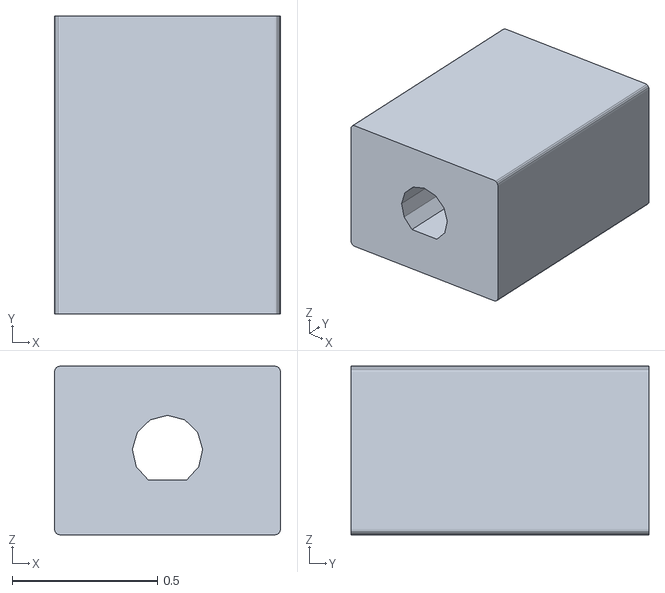
[picture p58: CAD file, 2026-10-17]
Base_Ignacio/Pieza_Eje_Giro_Base.stl
0.778 x 1.02 x 0.581
