rapha-gz-UC3M/Brazo_Robotico/Base_Igni/BR3E - Base Tapa Superior - Paleta 2.STL

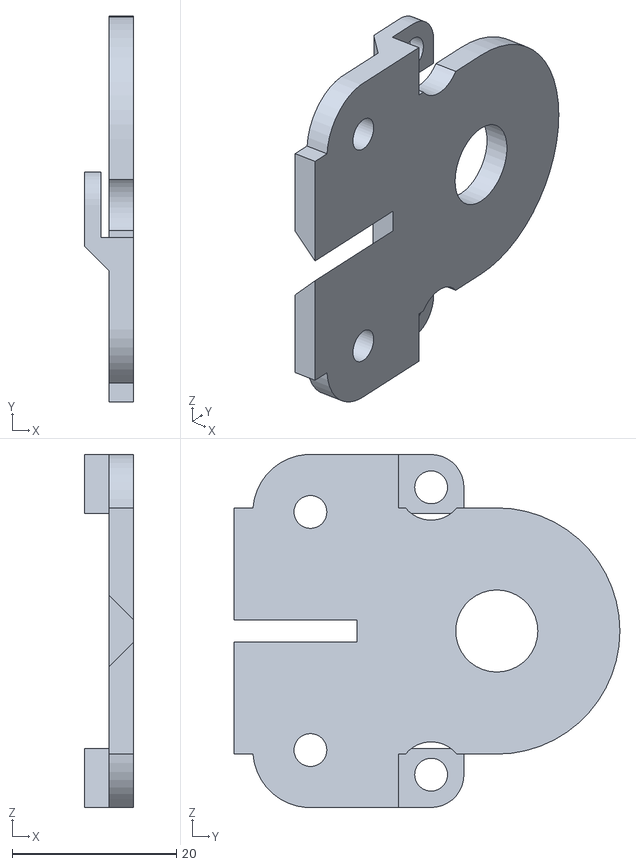
[picture p59: CAD file, 2026-10-06]
Base_Igni/BR3E - Base Tapa Superior - Paleta 2.STL
6.00 x 47.0 x 43.0
