rapha-gz-UC3M/Brazo_Robotico/Brazo_Vasil/BR3E - Brazo Parte 2.2.STL

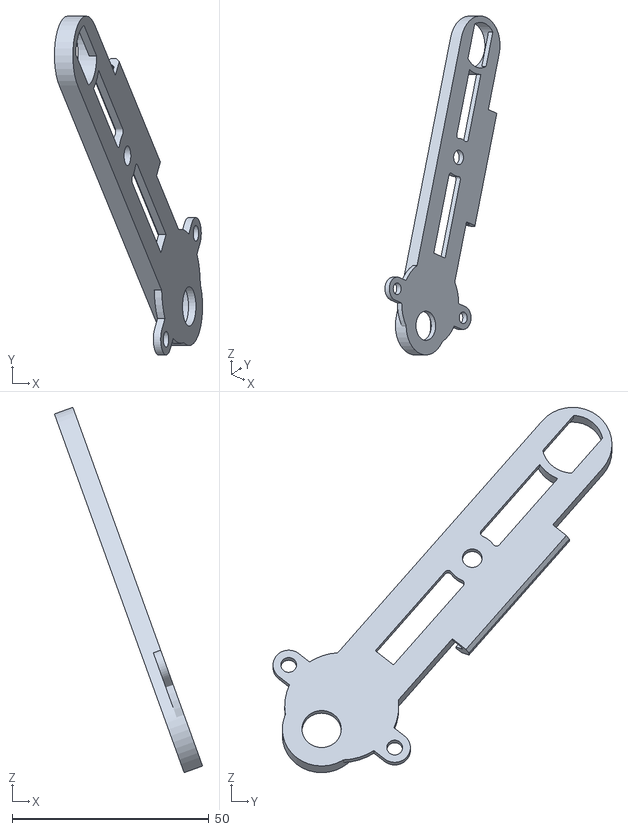
[picture p60: CAD file, 2026-10-06]
Brazo_Vasil/BR3E - Brazo Parte 2.2.STL
37.7 x 86.2 x 92.9
