rapha-gz-UC3M/Brazo_Robotico/Gripper_Rapha/ENSAMBLAJE/piezas_colocadas/Gripper_base_plate.stl

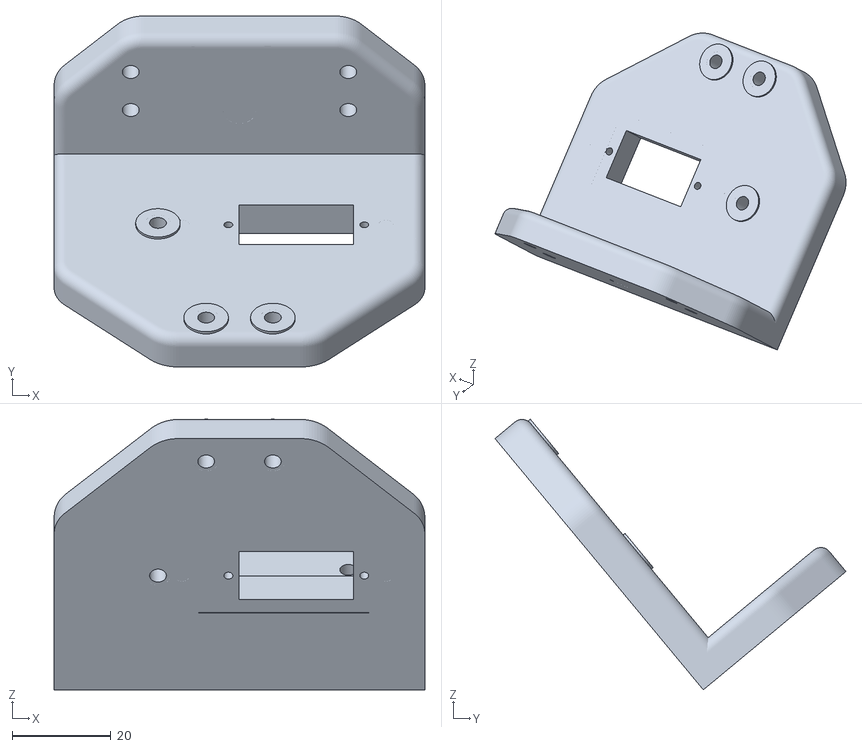
[picture p61: CAD file, 2026-10-24]
Gripper_Rapha/ENSAMBLAJE/piezas_colocadas/Gripper_base_plate.stl
75.0 x 71.0 x 54.8
