rapha-gz-UC3M/Brazo_Robotico/Gripper_Rapha/IMPRIMIR/1_base/Base_suplemento_15mm.stl

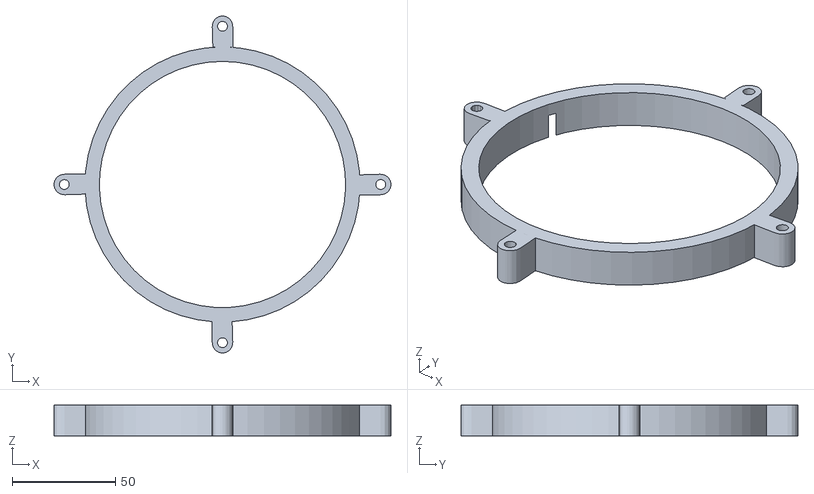
[picture p62: CAD file, 2026-10-24]
Gripper_Rapha/IMPRIMIR/1_base/Base_suplemento_15mm.stl
163.5 x 163.5 x 15.0
