rapha-gz-UC3M/Brazo_Robotico/Gripper_Rapha/shields_imprimibles/comprobacion/Shield_1_separadores_posicion_montaje.stl

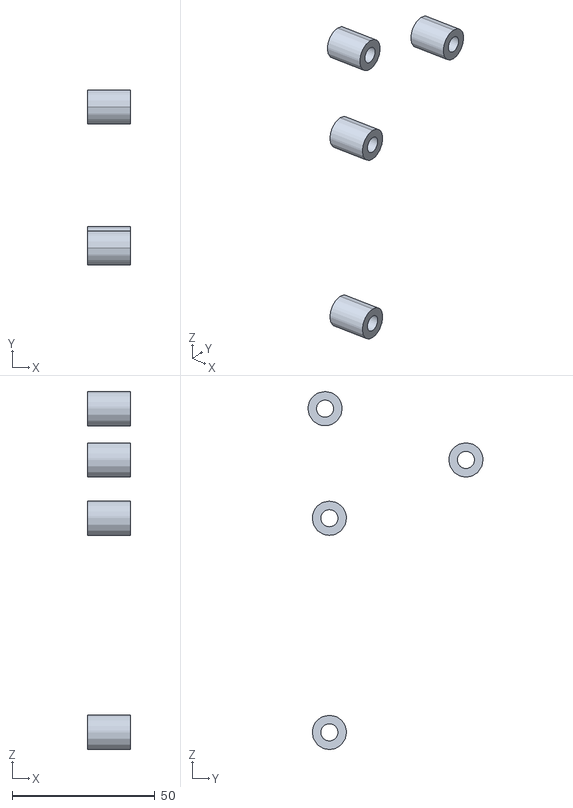
[picture p63: CAD file, 2026-10-21]
Gripper_Rapha/shields_imprimibles/comprobacion/Shield_1_separadores_posicion_montaje.stl
15.0 x 61.3 x 125.4
