rapha-gz-UC3M/Brazo_Robotico/Arm_Vasil/Brazo_modificado_STL/Piñon - 10 dientes - modulo 2_1.stl

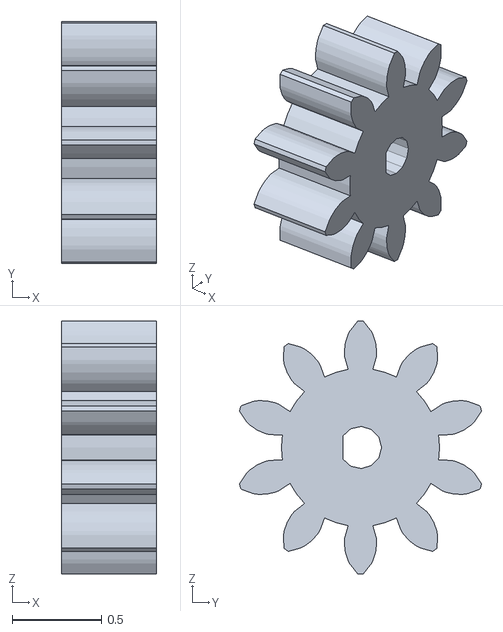
[picture p64: CAD file, 2026-10-21]
Arm_Vasil/Brazo_modificado_STL/Piñon - 10 dientes - modulo 2_1.stl
0.531 x 1.36 x 1.42
