rapha-gz-UC3M/Brazo_Robotico/Base_Igni/BR3E - Base Tapa Superior - Base.STL

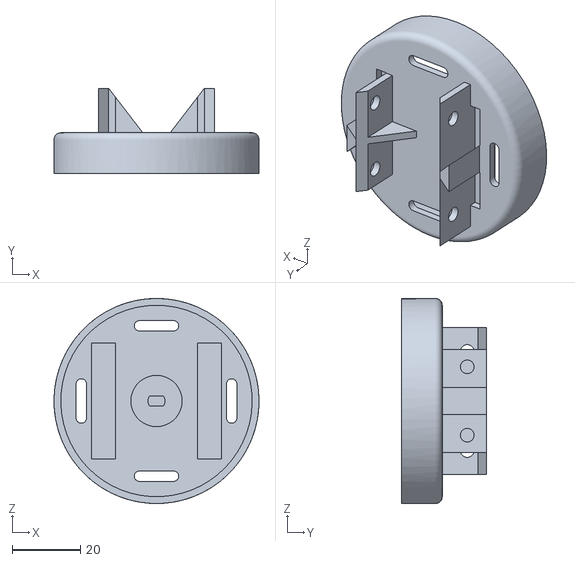
[picture p65: CAD file, 2026-10-06]
Base_Igni/BR3E - Base Tapa Superior - Base.STL
60.0 x 25.0 x 60.0
