rapha-gz-UC3M/Brazo_Robotico/Brazo_Vasil/BR3E - Eje Parte 2.STL

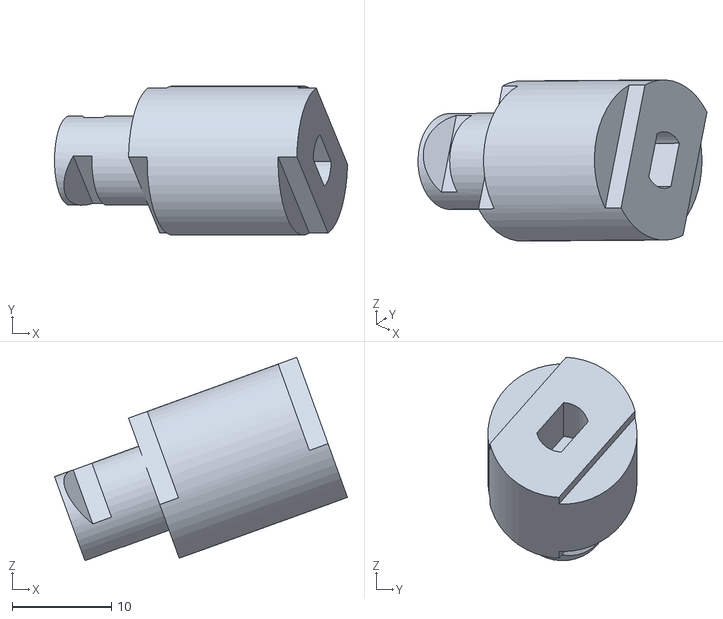
[picture p66: CAD file, 2026-10-06]
Brazo_Vasil/BR3E - Eje Parte 2.STL
29.5 x 15.0 x 20.5
