rapha-gz-UC3M/Brazo_Robotico/Gripper_Rapha/ensamblaje_completo/piezas_colocadas/Vasil_Corona_hombro.stl

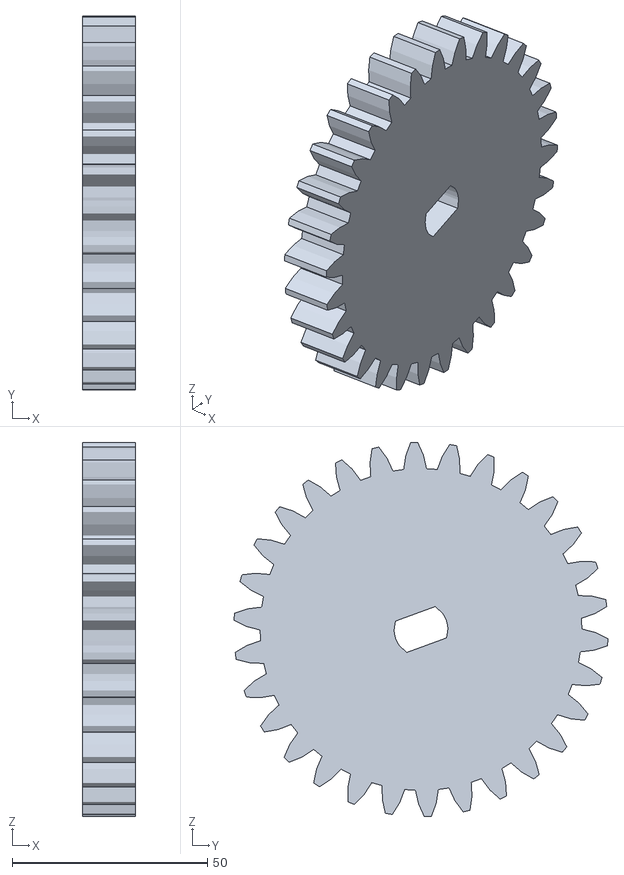
[picture p67: CAD file, 2026-10-21]
Gripper_Rapha/ensamblaje_completo/piezas_colocadas/Vasil_Corona_hombro.stl
13.5 x 95.9 x 96.0
