rapha-gz-UC3M/Brazo_Robotico/Gripper_Rapha/IMPRIMIR/2_brazo/Eje_Parte_2.stl

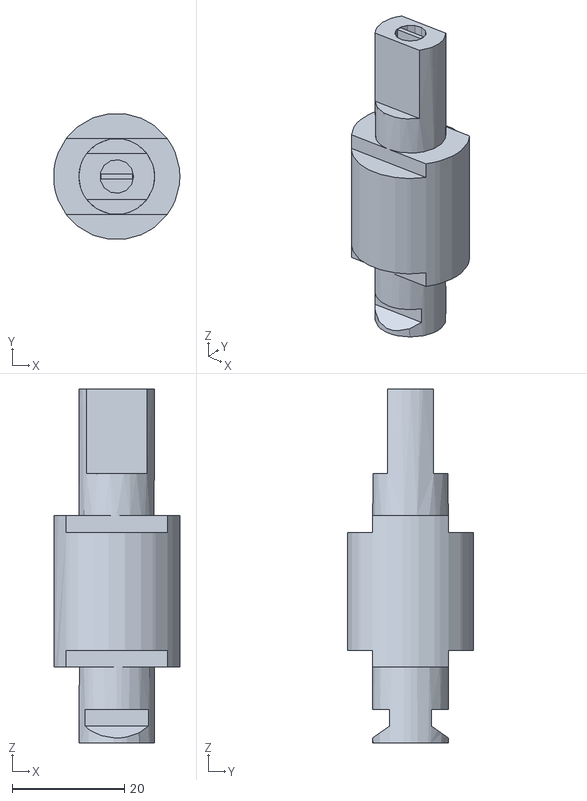
[picture p68: CAD file, 2026-10-24]
Gripper_Rapha/IMPRIMIR/2_brazo/Eje_Parte_2.stl
22.4 x 22.3 x 63.0
