rapha-gz-UC3M/Brazo_Robotico/Gripper_Rapha/imprimir_brazo/2_brazo_Vasil/Brazo_Parte_1.1_2.0_1.stl

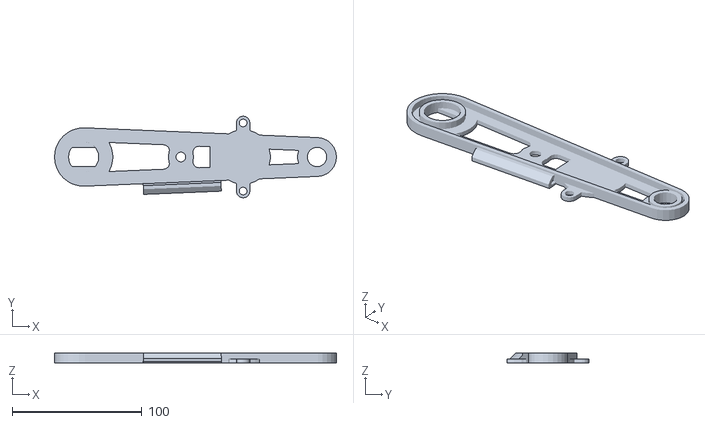
[picture p69: CAD file, 2026-10-21]
Gripper_Rapha/imprimir_brazo/2_brazo_Vasil/Brazo_Parte_1.1_2.0_1.stl
217.5 x 63.0 x 7.50
