rapha-gz-UC3M/Brazo_Robotico/Gripper_Rapha/piezas_mm/Arm_Vasil/Sujetador de eje_2.stl

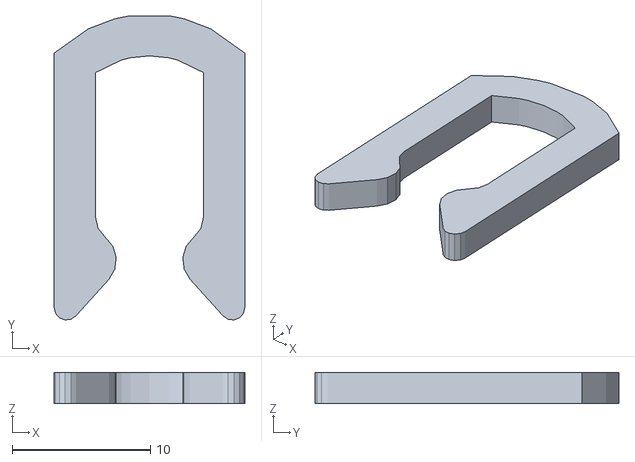
[picture p70: CAD file, 2026-10-21]
Gripper_Rapha/piezas_mm/Arm_Vasil/Sujetador de eje_2.stl
13.8 x 22.0 x 2.25
