rapha-gz-UC3M/Brazo_Robotico/Gripper_Rapha/shields_imprimibles/comprobacion/Shield_2_separadores_posicion_montaje.stl

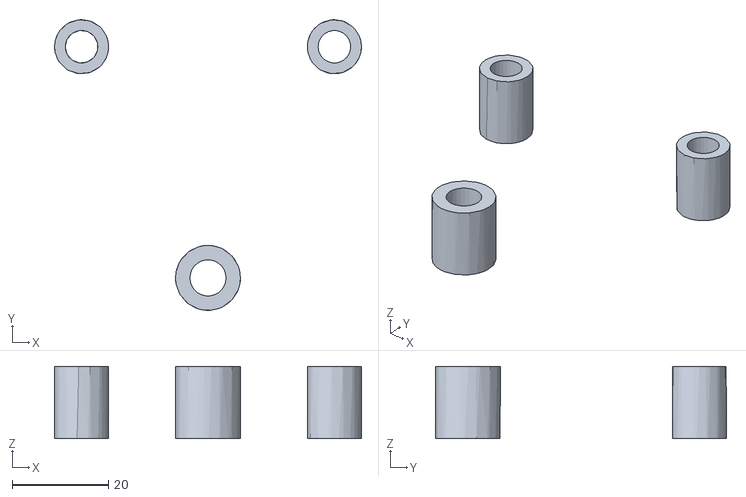
[picture p71: CAD file, 2026-10-21]
Gripper_Rapha/shields_imprimibles/comprobacion/Shield_2_separadores_posicion_montaje.stl
63.8 x 60.4 x 15.0
