rapha-gz-UC3M/Brazo_Robotico/Arm_Vasil/Brazo_modificado_STL/Brazo Parte 2_1.stl

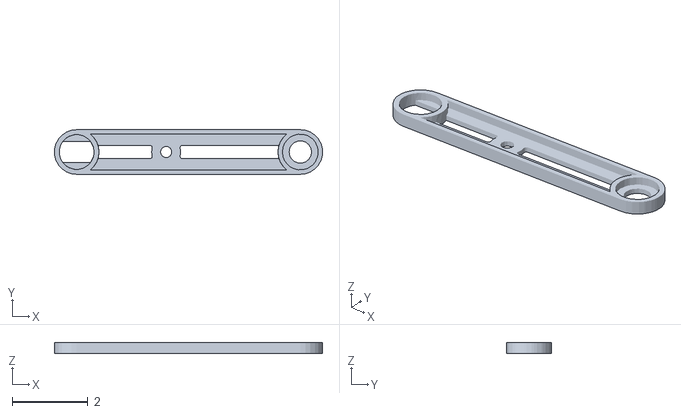
[picture p72: CAD file, 2026-10-21]
Arm_Vasil/Brazo_modificado_STL/Brazo Parte 2_1.stl
7.08 x 1.18 x 0.295
