rapha-gz-UC3M/Brazo_Robotico/Base_Igni/BR3E - Base Tapa Superior - Paleta 1.STL

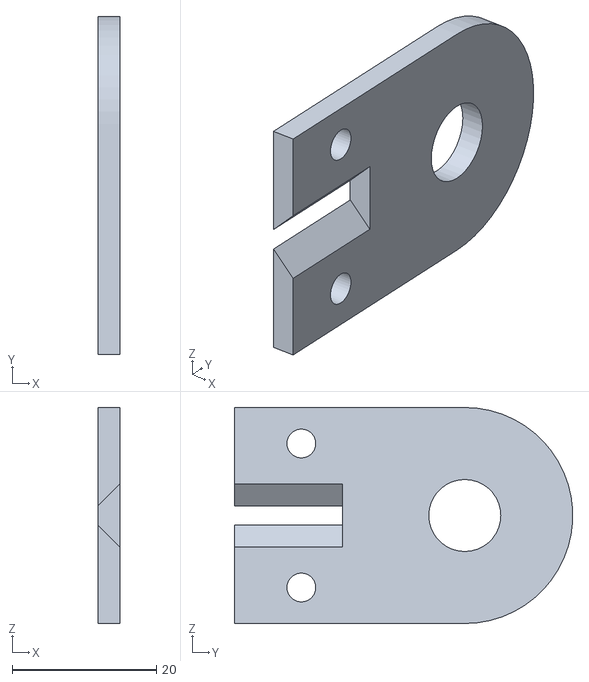
[picture p73: CAD file, 2026-10-06]
Base_Igni/BR3E - Base Tapa Superior - Paleta 1.STL
3.00 x 47.0 x 30.0
