rapha-gz-UC3M/Brazo_Robotico/Brazo_Vasil/BR3E - Brazo Parte 2.STL

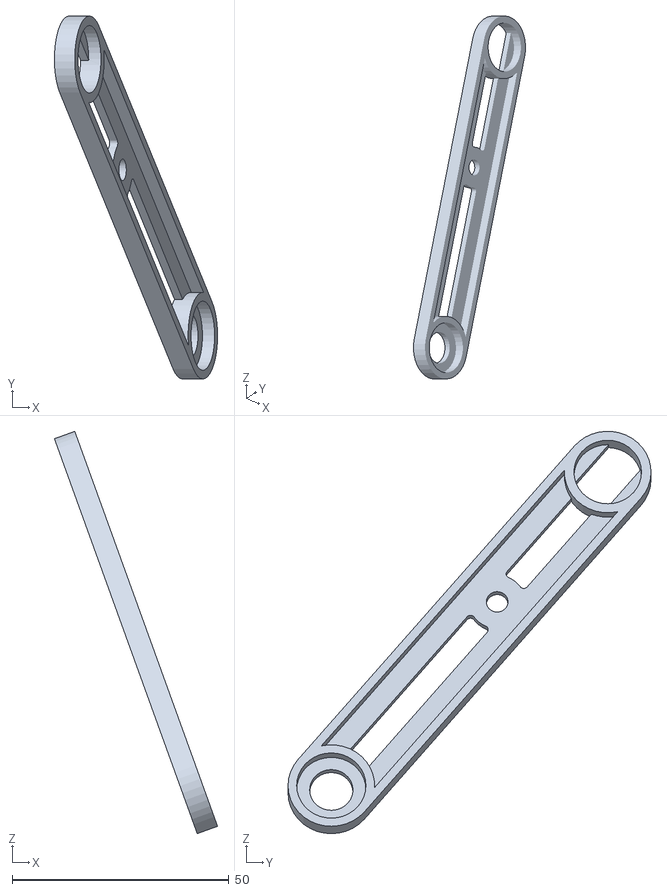
[picture p74: CAD file, 2026-10-06]
Brazo_Vasil/BR3E - Brazo Parte 2.STL
37.7 x 83.8 x 92.9
