rapha-gz-UC3M/Brazo_Robotico/Gripper_Rapha/comprobacion/REF_Brazo_Parte_2.2_4_Vasil.stl

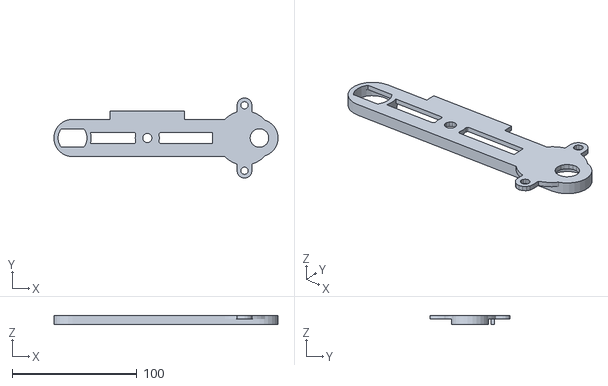
[picture p75: CAD file, 2026-10-21]
Gripper_Rapha/comprobacion/REF_Brazo_Parte_2.2_4_Vasil.stl
179.8 x 64.5 x 7.50
