rapha-gz-UC3M/Brazo_Robotico/Gripper_Rapha/ENSAMBLAJE/piezas_colocadas/Gripper_gear_left.stl

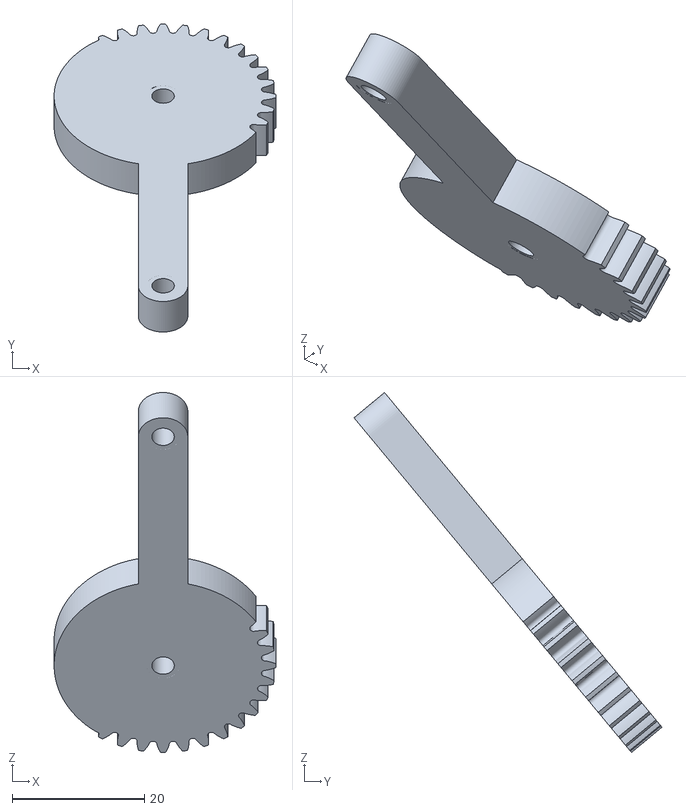
[picture p76: CAD file, 2026-10-24]
Gripper_Rapha/ENSAMBLAJE/piezas_colocadas/Gripper_gear_left.stl
33.6 x 46.6 x 54.5
