rapha-gz-UC3M/Brazo_Robotico/Gripper_Rapha/ensamblaje_completo/piezas_colocadas/Vasil_Brazo_Parte_2.2_4.stl

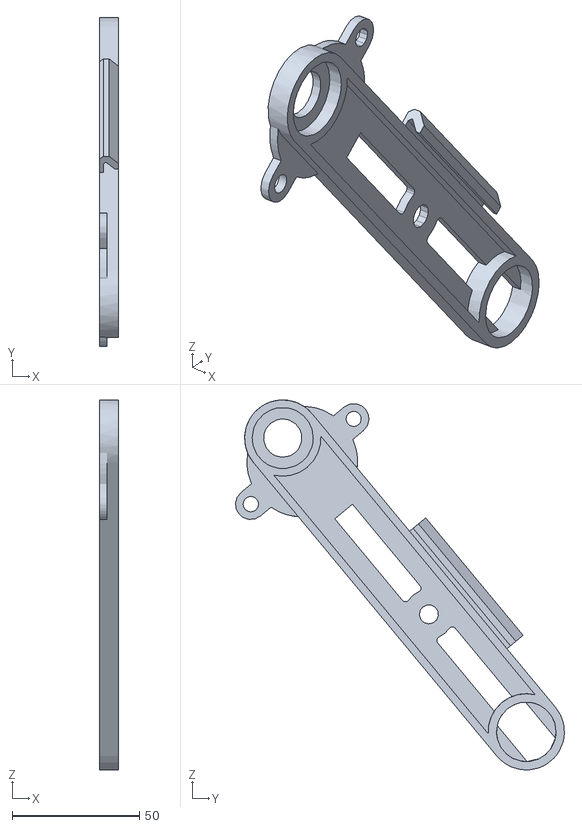
[picture p77: CAD file, 2026-10-21]
Gripper_Rapha/ensamblaje_completo/piezas_colocadas/Vasil_Brazo_Parte_2.2_4.stl
7.50 x 129.3 x 145.4
