rapha-gz-UC3M/Brazo_Robotico/Gripper_Rapha/IMPRIMIR/2_brazo/Paleta_1.stl

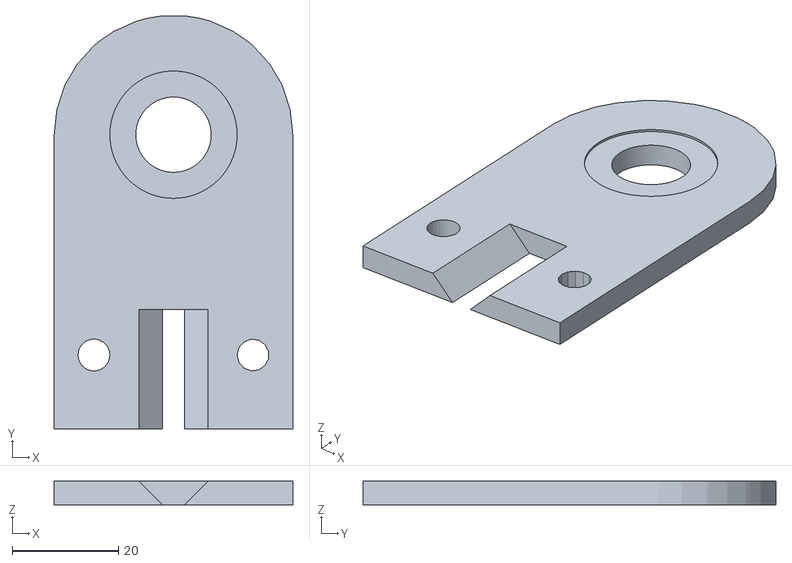
[picture p78: CAD file, 2026-10-24]
Gripper_Rapha/IMPRIMIR/2_brazo/Paleta_1.stl
45.0 x 77.9 x 4.50
