rapha-gz-UC3M/Brazo_Robotico/Gripper_Rapha/piezas_mm/Arm_Vasil/Base Tapa Superior - Paleta 2 - 2.0_1.stl

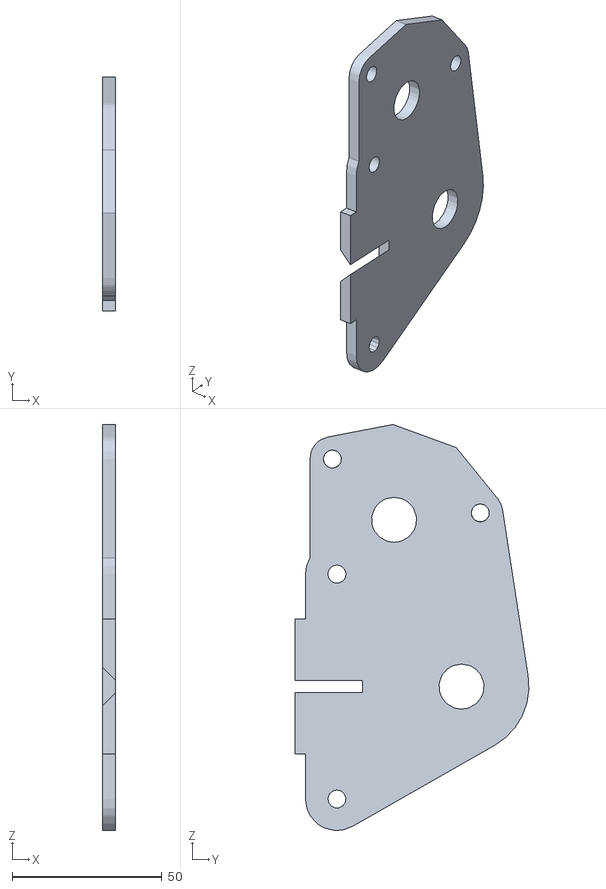
[picture p79: CAD file, 2026-10-21]
Gripper_Rapha/piezas_mm/Arm_Vasil/Base Tapa Superior - Paleta 2 - 2.0_1.stl
4.50 x 78.0 x 135.4
