rapha-gz-UC3M/Brazo_Robotico/Brazo_Vasil/BR3E - Brazo Parte 3 - Punta - Verción 3 ejes.STL

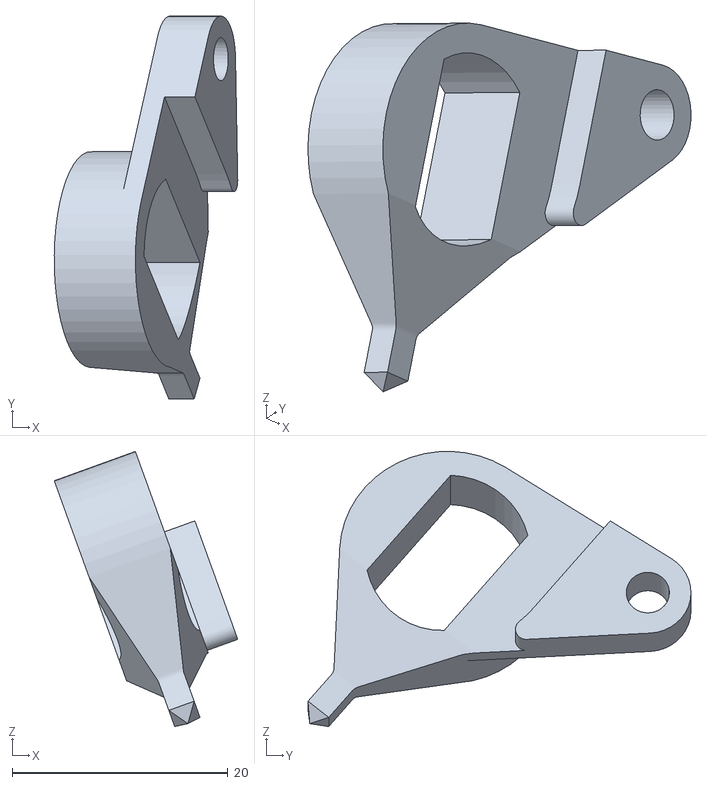
[picture p81: CAD file, 2026-10-06]
Brazo_Vasil/BR3E - Brazo Parte 3 - Punta - Verción 3 ejes.STL
17.0 x 35.5 x 25.5
