rapha-gz-UC3M/Brazo_Robotico/Gripper_Rapha/ensamblaje_completo/piezas_colocadas/Vasil_Brazo_Parte_2_1.stl

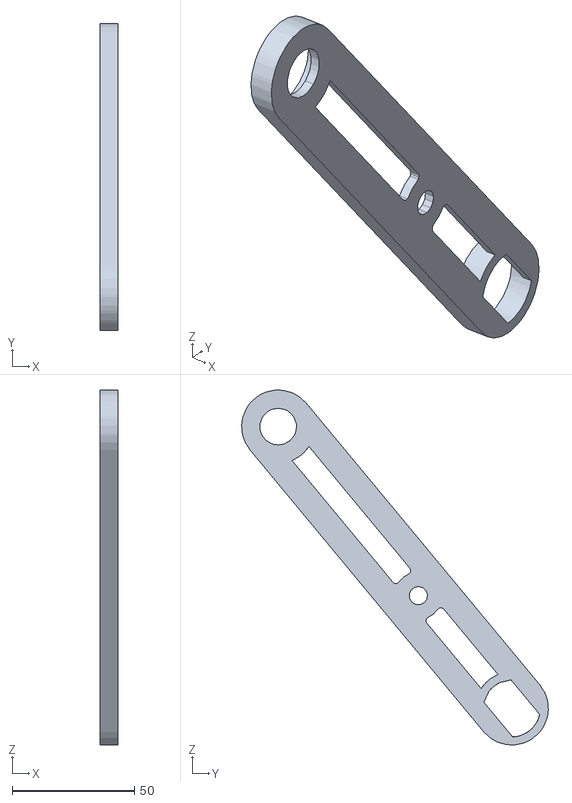
[picture p82: CAD file, 2026-10-21]
Gripper_Rapha/ensamblaje_completo/piezas_colocadas/Vasil_Brazo_Parte_2_1.stl
7.50 x 125.7 x 145.5
