rapha-gz-UC3M/Brazo_Robotico/Gripper_Rapha/GRIPPER/comprobacion/REF_Brazo_Parte_2_1_Vasil.stl

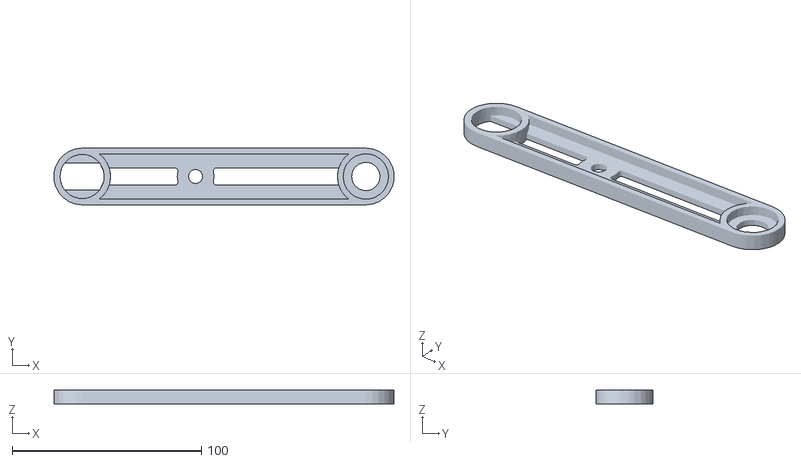
[picture p83: CAD file, 2026-10-24]
Gripper_Rapha/GRIPPER/comprobacion/REF_Brazo_Parte_2_1_Vasil.stl
179.8 x 30.0 x 7.50
