rapha-gz-UC3M/Brazo_Robotico/Arm_Vasil/Brazo_modificado_STL/Sujetador de eje_2.stl

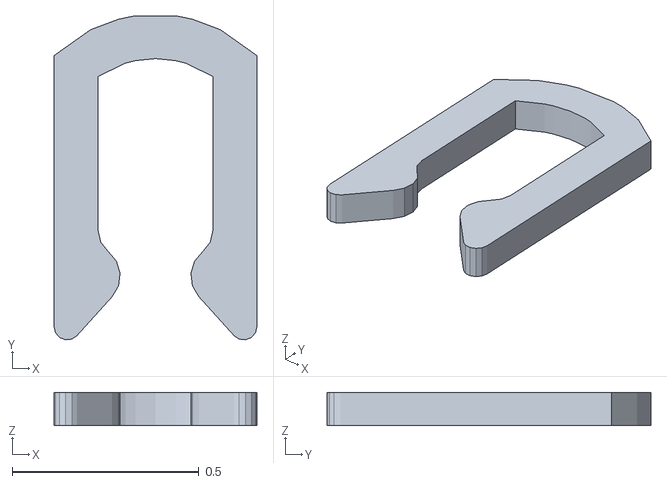
[picture p84: CAD file, 2026-10-21]
Arm_Vasil/Brazo_modificado_STL/Sujetador de eje_2.stl
0.543 x 0.866 x 0.0886
