rapha-gz-UC3M/Brazo_Robotico/Brazo_Vasil/BR3E - Brazo Parte 1.1.STL

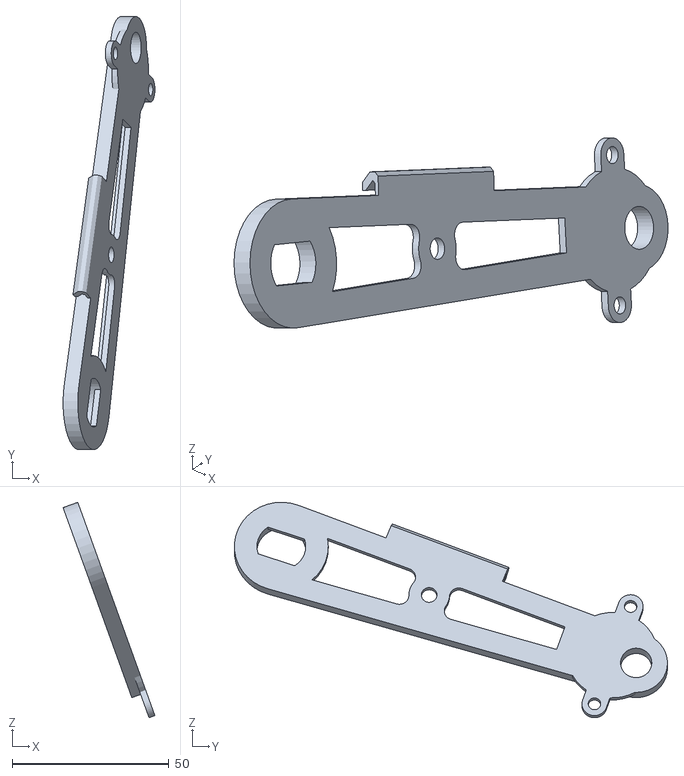
[picture p85: CAD file, 2026-10-06]
Brazo_Vasil/BR3E - Brazo Parte 1.1.STL
29.3 x 138.2 x 68.8
