rapha-gz-UC3M/Brazo_Robotico/Gripper_Rapha/ENSAMBLAJE/piezas_colocadas/Gripper_arm_right.stl

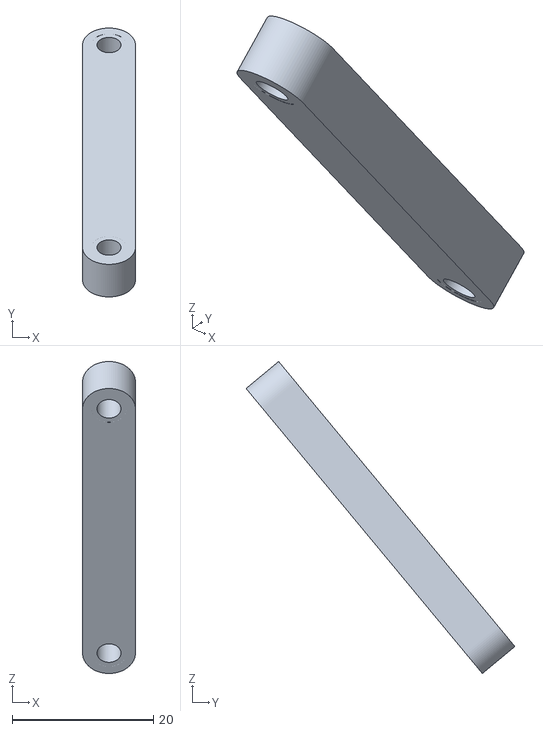
[picture p86: CAD file, 2026-10-24]
Gripper_Rapha/ENSAMBLAJE/piezas_colocadas/Gripper_arm_right.stl
7.50 x 38.1 x 44.2
