rapha-gz-UC3M/Brazo_Robotico/Gripper_Rapha/imprimir_brazo/2_brazo_Vasil/Base_Tapa_Superior_Paleta_1_2.0_1.stl

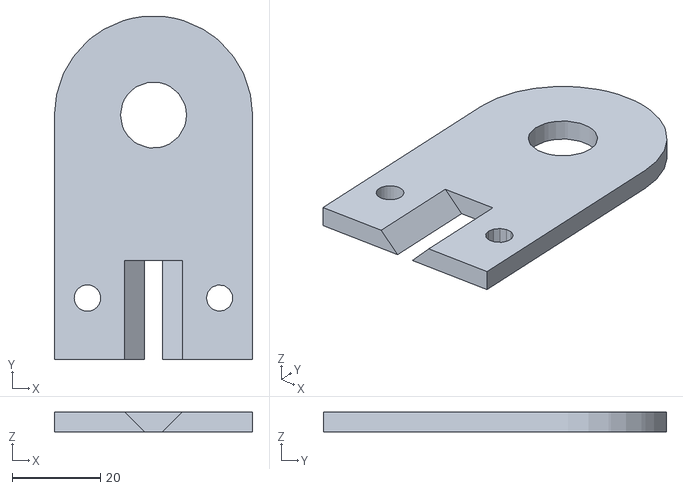
[picture p87: CAD file, 2026-10-21]
Gripper_Rapha/imprimir_brazo/2_brazo_Vasil/Base_Tapa_Superior_Paleta_1_2.0_1.stl
45.0 x 77.9 x 4.50
