rapha-gz-UC3M/Brazo_Robotico/Arm_Vasil/Brazo_modificado_STL/Eje Parte 3_1.stl

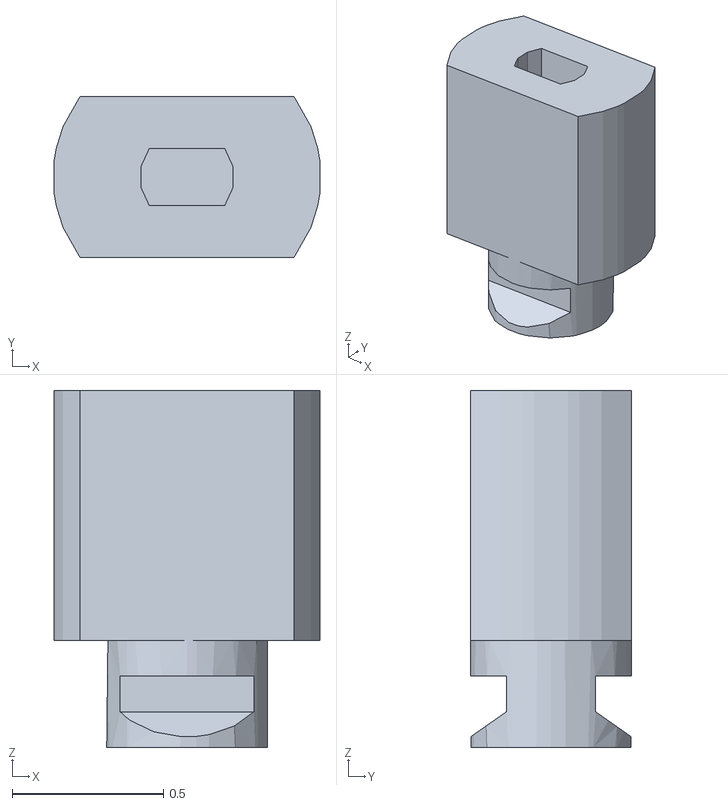
[picture p88: CAD file, 2026-10-21]
Arm_Vasil/Brazo_modificado_STL/Eje Parte 3_1.stl
0.879 x 0.531 x 1.18
