rapha-gz-UC3M/Brazo_Robotico/Brazo_Vasil/BR3E - Eje Parte 1.STL

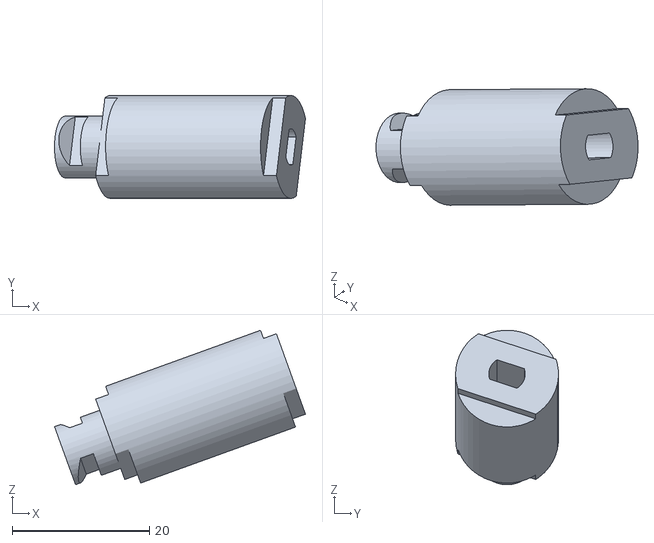
[picture p89: CAD file, 2026-10-06]
Brazo_Vasil/BR3E - Eje Parte 1.STL
36.6 x 15.0 x 22.5
