rapha-gz-UC3M/Brazo_Robotico/Gripper_Rapha/ensamblaje_completo/piezas_colocadas/Rapha_jaw_right.stl

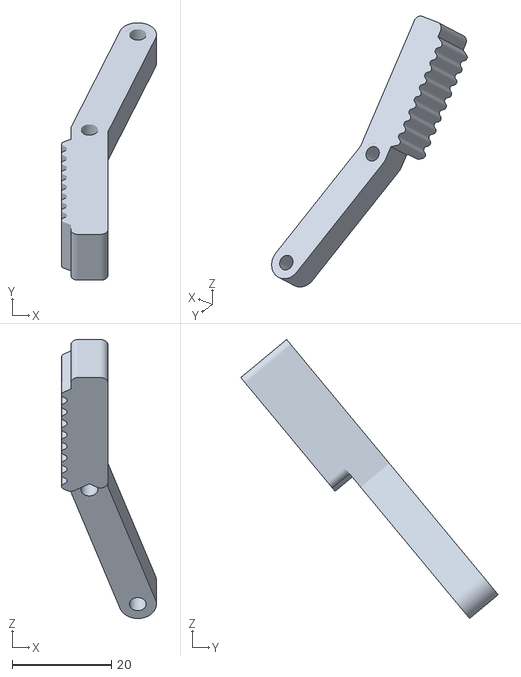
[picture p90: CAD file, 2026-10-21]
Gripper_Rapha/ensamblaje_completo/piezas_colocadas/Rapha_jaw_right.stl
19.1 x 51.8 x 56.2
