rapha-gz-UC3M/Brazo_Robotico/Gripper_Rapha/piezas_mm/Arm_Vasil/Shield 2 - 2.0_1.stl

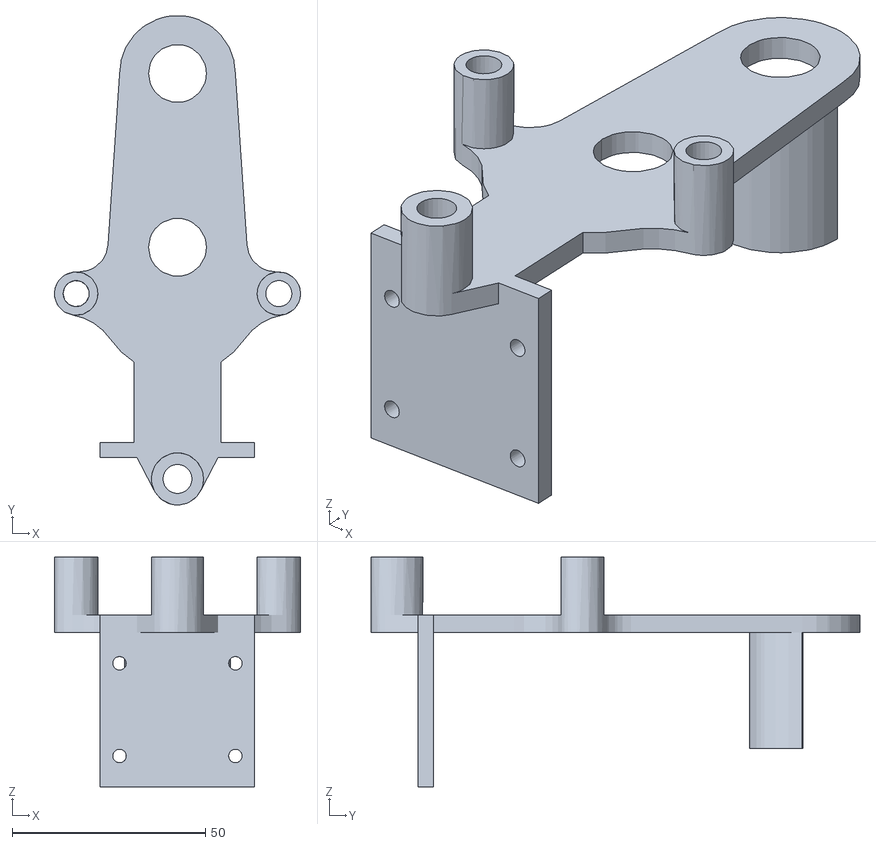
[picture p91: CAD file, 2026-10-21]
Gripper_Rapha/piezas_mm/Arm_Vasil/Shield 2 - 2.0_1.stl
63.8 x 126.6 x 59.5
