rapha-gz-UC3M/Brazo_Robotico/Arm_Vasil/Brazo_modificado_STL/Base Tapa Superior - Paleta 2 - 2.0_1.stl

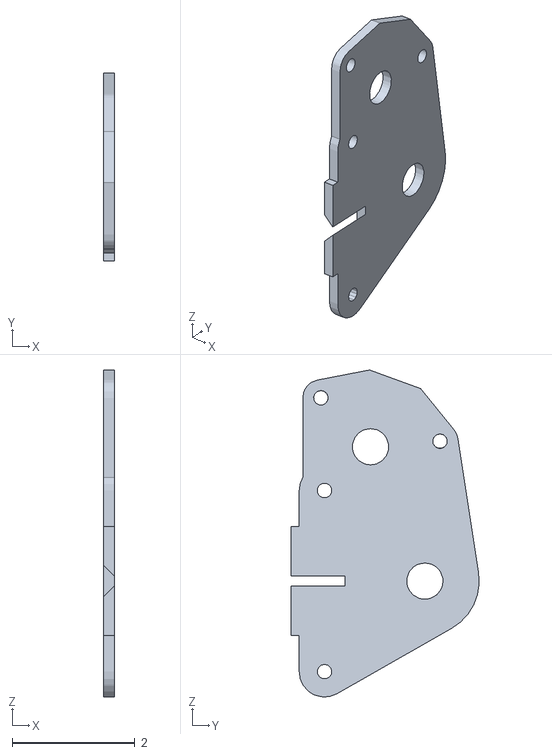
[picture p92: CAD file, 2026-10-21]
Arm_Vasil/Brazo_modificado_STL/Base Tapa Superior - Paleta 2 - 2.0_1.stl
0.177 x 3.07 x 5.33
