rapha-gz-UC3M/Brazo_Robotico/Brazo_Vasil/BR3E - Eje Parte 3.STL

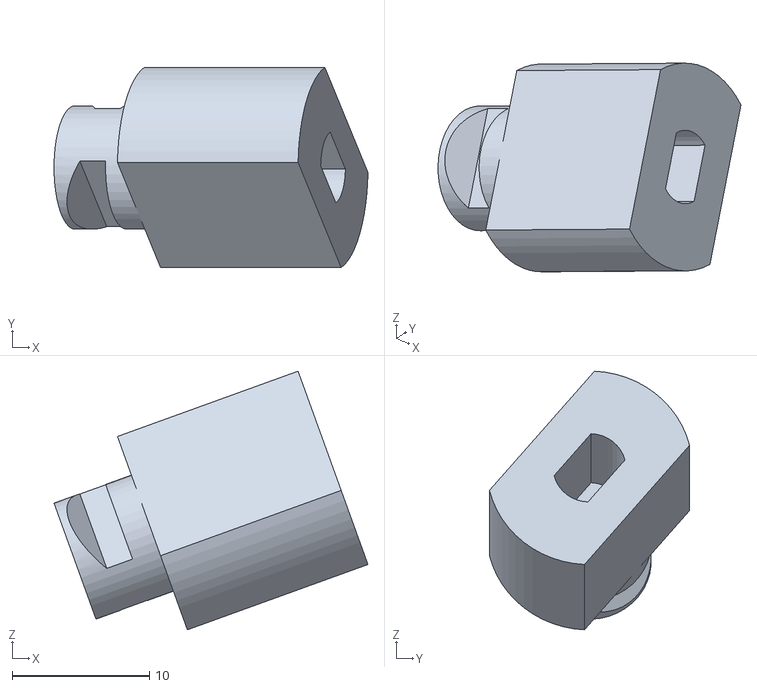
[picture p93: CAD file, 2026-10-06]
Brazo_Vasil/BR3E - Eje Parte 3.STL
22.9 x 14.6 x 18.9
