rapha-gz-UC3M/Brazo_Robotico/Arm_Vasil/Brazo_modificado_STL/Eje Parte 1 - 2.0_1.stl

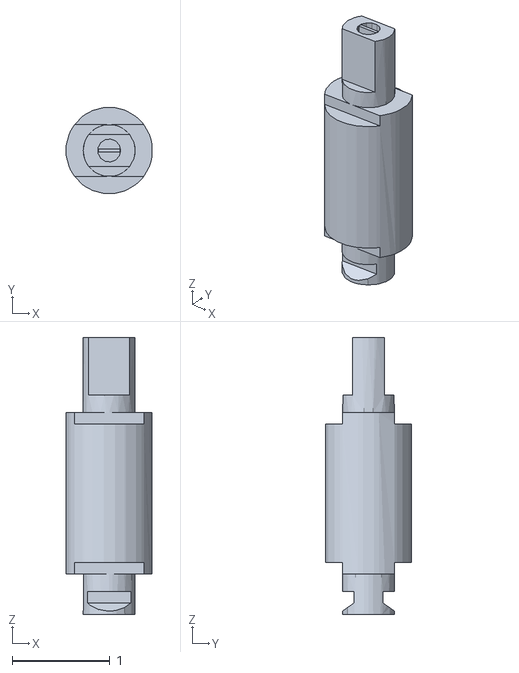
[picture p94: CAD file, 2026-10-21]
Arm_Vasil/Brazo_modificado_STL/Eje Parte 1 - 2.0_1.stl
0.882 x 0.879 x 2.83
