rapha-gz-UC3M/Brazo_Robotico/Gripper_Rapha/ENSAMBLAJE/piezas_colocadas/Sujetador_codo.stl

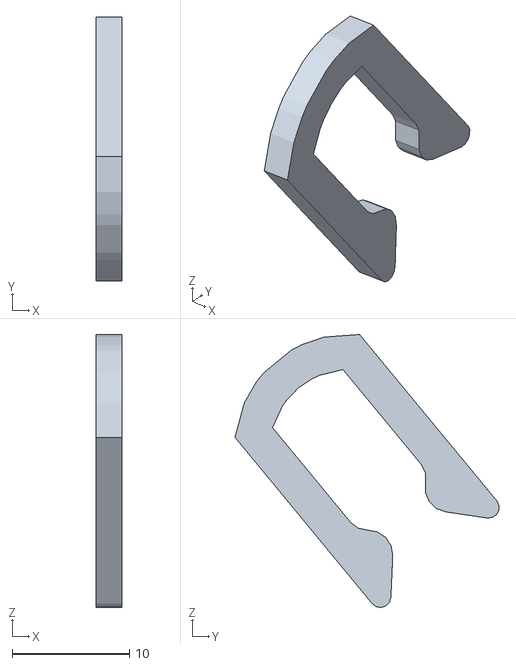
[picture p95: CAD file, 2026-10-24]
Gripper_Rapha/ENSAMBLAJE/piezas_colocadas/Sujetador_codo.stl
2.25 x 22.6 x 23.3
