rapha-gz-UC3M/Brazo_Robotico/Gripper_Rapha/ensamblaje_completo/piezas_colocadas/Rapha_gear_right.stl

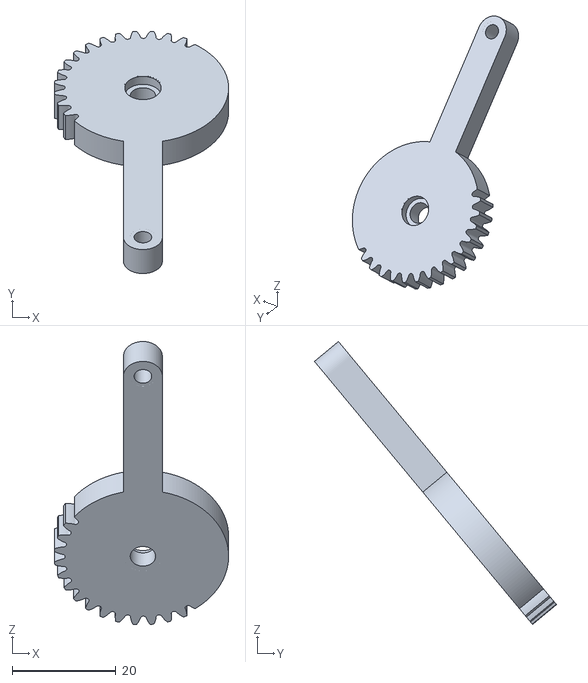
[picture p96: CAD file, 2026-10-21]
Gripper_Rapha/ensamblaje_completo/piezas_colocadas/Rapha_gear_right.stl
33.5 x 46.6 x 54.5
