rapha-gz-UC3M/Brazo_Robotico/Arm_Vasil/Brazo_modificado_STL/Corona - 30 dientes - modulo 2_1.stl

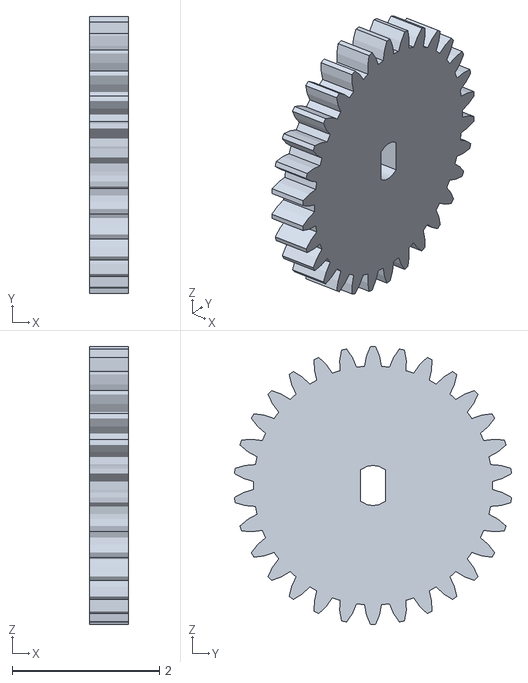
[picture p97: CAD file, 2026-10-21]
Arm_Vasil/Brazo_modificado_STL/Corona - 30 dientes - modulo 2_1.stl
0.531 x 3.77 x 3.78
