rapha-gz-UC3M/Brazo_Robotico/(list of files, cad)

Other CAD files:
Gripper_Rapha/solid_edge/Ensamblaje_Gripper_Brazo_Vasil/Ensamblaje_Gripper_Brazo_Vasil_x1.5.step
Gripper_Rapha/comprobacion/ASM_gear_left.stl
Gripper_Rapha/GRIPPER/comprobacion/ASM_jaw_left.stl
Gripper_Rapha/comprobacion/ASM_arm_left.stl
Gripper_Rapha/comprobacion/ASM_servo_MG90S_aprox.stl
Gripper_Rapha/comprobacion/ASM_arm_right.stl
Gripper_Rapha/comprobacion/ASM_jaw_left.stl
Gripper_Rapha/base_sup_imprimible/comprobacion/BASE_TAPA_SUP_pestana_posicion_montaje.stl
Gripper_Rapha/IMPRIMIR/3_gripper/base_plate.stl
Gripper_Rapha/imprimir_brazo/3_gripper_Rapha/arm_right_x1.5.stl
Gripper_Rapha/base_sup_imprimible/comprobacion/BASE_TAPA_SUP_imprimible_posicion_montaje.stl
Gripper_Rapha/GRIPPER/original/gripper_superbtech/jaw_right.stl
Gripper_Rapha/IMPRIMIR/3_gripper/casquillo_punta.stl
Gripper_Rapha/imprimir_brazo/3_gripper_Rapha/arm_left_x1.5.stl
Gripper_Rapha/shields_imprimibles/comprobacion/Shield_2_placa_posicion_montaje.stl
Gripper_Rapha/ensamblaje_completo/piezas_colocadas/Vasil_Sujetador_hombro.stl
Gripper_Rapha/IMPRIMIR/2_brazo/Eje_Parte_1.stl
Gripper_Rapha/IMPRIMIR/3_gripper/jaw_right.stl
Gripper_Rapha/imprimir_brazo/2_brazo_Vasil/Shield_2_separadores_x3.stl
Gripper_Rapha/imprimir_brazo/3_gripper_Rapha/gear_right_x1.5.stl
Gripper_Rapha/piezas_mm/Arm_Vasil/Eje Parte 1 - 2.0_1.stl
Gripper_Rapha/shields_imprimibles/Shield_2_imprimible.stl
Gripper_Rapha/ENSAMBLAJE/piezas_colocadas/Pieza_Eje_Giro_Base.stl
Gripper_Rapha/IMPRIMIR/1_base/BASE_TAPA_SUP_cuerpo.stl
Gripper_Rapha/IMPRIMIR/3_gripper/jaw_left.stl
Gripper_Rapha/imprimir_brazo/3_gripper_Rapha/acople_punta_vasil_x1.5.stl
Gripper_Rapha/shields_imprimibles/Shield_1_imprimible.stl
Gripper_Rapha/GRIPPER/comprobacion/REF_Brazo_Parte_2.2_4_Vasil.stl
Gripper_Rapha/IMPRIMIR/1_base/BASE_TAPA_SUP_pestana.stl
Gripper_Rapha/IMPRIMIR/3_gripper/arm_right.stl
Gripper_Rapha/imprimir_brazo/2_brazo_Vasil/Eje_Parte_1_2.0_1.stl
Gripper_Rapha/imprimir_brazo/3_gripper_Rapha/casquillo_punta_x1.5.stl
Gripper_Rapha/ENSAMBLAJE/piezas_colocadas/Paleta_1.stl
Gripper_Rapha/IMPRIMIR/2_brazo/Shield_2_separadores_x3.stl
Gripper_Rapha/IMPRIMIR/3_gripper/gear_right.stl
Gripper_Rapha/imprimir_brazo/2_brazo_Vasil/Sujetador_de_eje_x2.stl
Gripper_Rapha/imprimir_brazo/3_gripper_Rapha/contraplaca_acople_x1.5.stl
Gripper_Rapha/piezas_mm/Arm_Vasil/Piñon - 10 dientes - modulo 2_1.stl
Gripper_Rapha/ensamblaje_completo/piezas_colocadas/Rapha_arm_right.stl
Gripper_Rapha/IMPRIMIR/2_brazo/Brazo_Parte_2.2_4.stl
Gripper_Rapha/IMPRIMIR/3_gripper/gear_left.stl
Gripper_Rapha/imprimir_brazo/3_gripper_Rapha/jaw_right_x1.5.stl
Gripper_Rapha/piezas_mm/Arm_Vasil/Corona - 30 dientes - modulo 2_1.stl
Gripper_Rapha/comprobacion/REF_Brazo_Parte_2_1_Vasil.stl
Gripper_Rapha/ENSAMBLAJE/piezas_colocadas/Gripper_arm_left.stl
Gripper_Rapha/IMPRIMIR/2_brazo/Paleta_2.stl
Gripper_Rapha/IMPRIMIR/3_gripper/arm_left.stl
Gripper_Rapha/imprimir_brazo/2_brazo_Vasil/Brazo_Parte_2_1.stl
Gripper_Rapha/imprimir_brazo/3_gripper_Rapha/gear_left_x1.5.stl
Gripper_Rapha/ENSAMBLAJE/piezas_colocadas/Brazo_Parte_2.2_4.stl
Gripper_Rapha/ensamblaje_completo/piezas_colocadas/Rapha_base_plate.stl
Gripper_Rapha/IMPRIMIR/2_brazo/Shield_1_separadores_x4.stl
Gripper_Rapha/IMPRIMIR/3_gripper/acople_punta.stl
Gripper_Rapha/imprimir_brazo/2_brazo_Vasil/Brazo_Parte_2.2_4.stl
Gripper_Rapha/imprimir_brazo/3_gripper_Rapha/base_plate_x1.5.stl
Gripper_Rapha/piezas_mm/Arm_Vasil/Eje Parte 2 - 2.0_1.stl
Gripper_Rapha/IMPRIMIR/2_brazo/Brazo_Parte_2_1.stl
Gripper_Rapha/IMPRIMIR/3_gripper/contraplaca_acople.stl
Gripper_Rapha/imprimir_brazo/2_brazo_Vasil/Base_Tapa_Superior_Paleta_2_2.0_1.stl
Gripper_Rapha/imprimir_brazo/3_gripper_Rapha/jaw_left_x1.5.stl
Gripper_Rapha/piezas_mm/Arm_Vasil/Brazo Parte 1.1 2.0_1.stl
Gripper_Rapha/ENSAMBLAJE/piezas_colocadas/Shield_1_separadores_x4.stl
Arm_Vasil/Brazo_modificado_STL/Base Tapa Superior - Paleta 1 - 2.0_1.stl
Arm_Vasil/Brazo_modificado_STL/Brazo Parte 1.1 2.0_1.stl
Arm_Vasil/Brazo_modificado_STL/Shield 2 - 2.0_1.stl
Gripper_Rapha/ENSAMBLAJE/piezas_colocadas/BASE_TAPA_INF.stl
Gripper_Rapha/ENSAMBLAJE/piezas_colocadas/BASE_TAPA_SUP_cuerpo.stl
Gripper_Rapha/ENSAMBLAJE/piezas_colocadas/BASE_TAPA_SUP_pestana.stl
Gripper_Rapha/ENSAMBLAJE/piezas_colocadas/Base_suplemento_15mm.stl
Gripper_Rapha/ENSAMBLAJE/piezas_colocadas/Brazo_Parte_1.1.stl
Gripper_Rapha/ENSAMBLAJE/piezas_colocadas/Brazo_Parte_2_1.stl
Gripper_Rapha/ENSAMBLAJE/piezas_colocadas/Corona_codo.stl
Gripper_Rapha/ENSAMBLAJE/piezas_colocadas/Corona_hombro.stl
Gripper_Rapha/ENSAMBLAJE/piezas_colocadas/Eje_Parte_1.stl
Gripper_Rapha/ENSAMBLAJE/piezas_colocadas/Eje_Parte_2.stl
Gripper_Rapha/ENSAMBLAJE/piezas_colocadas/Gripper_acople_punta.stl
Gripper_Rapha/ENSAMBLAJE/piezas_colocadas/Gripper_casquillo_punta.stl
Gripper_Rapha/ENSAMBLAJE/piezas_colocadas/Gripper_contraplaca_acople.stl
Gripper_Rapha/ENSAMBLAJE/piezas_colocadas/Gripper_gear_right.stl
Gripper_Rapha/ENSAMBLAJE/piezas_colocadas/Gripper_jaw_left.stl
Gripper_Rapha/ENSAMBLAJE/piezas_colocadas/Gripper_jaw_right.stl
Gripper_Rapha/ENSAMBLAJE/piezas_colocadas/Gripper_servo_MG90S_aprox.stl
Gripper_Rapha/ENSAMBLAJE/piezas_colocadas/Paleta_2.stl
Gripper_Rapha/ENSAMBLAJE/piezas_colocadas/Pinon_codo.stl
Gripper_Rapha/ENSAMBLAJE/piezas_colocadas/Pinon_hombro.stl
Gripper_Rapha/ENSAMBLAJE/piezas_colocadas/Shield_1_placa.stl
Gripper_Rapha/ENSAMBLAJE/piezas_colocadas/Shield_2_placa.stl
Gripper_Rapha/ENSAMBLAJE/piezas_colocadas/Shield_2_separadores_x3.stl
Gripper_Rapha/IMPRIMIR/2_brazo/Brazo_Parte_1.1.stl
Gripper_Rapha/IMPRIMIR/2_brazo/Brazo_Parte_1_1.stl
Gripper_Rapha/IMPRIMIR/2_brazo/Manguito_potenciometro_x2.stl
Gripper_Rapha/IMPRIMIR/2_brazo/Pinon_10_dientes_x2.stl
Gripper_Rapha/IMPRIMIR/2_brazo/Shield_1_placa.stl
Gripper_Rapha/IMPRIMIR/2_brazo/Shield_2_placa.stl
Gripper_Rapha/ensamblaje_completo/piezas_colocadas/Ignacio_BASE_TAPA_INF.stl
Gripper_Rapha/ensamblaje_completo/piezas_colocadas/Ignacio_BASE_TAPA_SUP.stl
Gripper_Rapha/ensamblaje_completo/piezas_colocadas/Ignacio_Pieza_Eje_Giro_Base.stl
Gripper_Rapha/ensamblaje_completo/piezas_colocadas/REF_motor_JGB37_base.stl
Gripper_Rapha/ensamblaje_completo/piezas_colocadas/REF_motor_JGB37_hombro.stl
Gripper_Rapha/ensamblaje_completo/piezas_colocadas/Rapha_acople_punta_vasil.stl
Gripper_Rapha/ensamblaje_completo/piezas_colocadas/Rapha_arm_left.stl
Gripper_Rapha/ensamblaje_completo/piezas_colocadas/Rapha_casquillo_punta.stl
Gripper_Rapha/ensamblaje_completo/piezas_colocadas/Rapha_contraplaca_acople.stl
Gripper_Rapha/ensamblaje_completo/piezas_colocadas/Rapha_gear_left.stl
Gripper_Rapha/ensamblaje_completo/piezas_colocadas/Rapha_jaw_left.stl
Gripper_Rapha/ensamblaje_completo/piezas_colocadas/Rapha_servo_MG90S_aprox.stl
Gripper_Rapha/ensamblaje_completo/piezas_colocadas/Vasil_Brazo_Parte_1.1.stl
Gripper_Rapha/ensamblaje_completo/piezas_colocadas/Vasil_Brazo_Parte_1_1.stl
Gripper_Rapha/ensamblaje_completo/piezas_colocadas/Vasil_Eje_Parte_2.stl
Gripper_Rapha/ensamblaje_completo/piezas_colocadas/Vasil_Paleta_1.stl
Gripper_Rapha/ensamblaje_completo/piezas_colocadas/Vasil_Paleta_2.stl
Gripper_Rapha/ensamblaje_completo/piezas_colocadas/Vasil_Shield_1.stl
Gripper_Rapha/ensamblaje_completo/piezas_colocadas/Vasil_Shield_2.stl
Gripper_Rapha/ensamblaje_completo/piezas_colocadas/Vasil_Sujetador_codo.stl
Gripper_Rapha/imprimir/acople_punta_vasil_x1.5.stl
Gripper_Rapha/imprimir/arm_left_x1.5.stl
Gripper_Rapha/imprimir/arm_right_x1.5.stl
Gripper_Rapha/imprimir/base_plate_x1.5.stl
Gripper_Rapha/imprimir/gear_left_x1.5.stl
Gripper_Rapha/imprimir/gear_right_x1.5.stl
Gripper_Rapha/imprimir/jaw_left_x1.5.stl
Gripper_Rapha/imprimir/jaw_right_x1.5.stl
Gripper_Rapha/imprimir_brazo/1_base_Ignacio/BASE_TAPA_INF.stl
Gripper_Rapha/imprimir_brazo/1_base_Ignacio/Pieza_Eje_Giro_Base.stl
Gripper_Rapha/imprimir_brazo/2_brazo_Vasil/Brazo_Parte_1_1.stl
Gripper_Rapha/imprimir_brazo/2_brazo_Vasil/Corona_30_dientes_modulo_2_1.stl
Gripper_Rapha/imprimir_brazo/2_brazo_Vasil/Eje_Parte_2_2.0_agujero_D_6.15.stl
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
