rapha-gz-UC3M/Brazo_Robotico/Gripper_Rapha/ENSAMBLAJE/explosionados/explosionado_0_brazo_completo.png

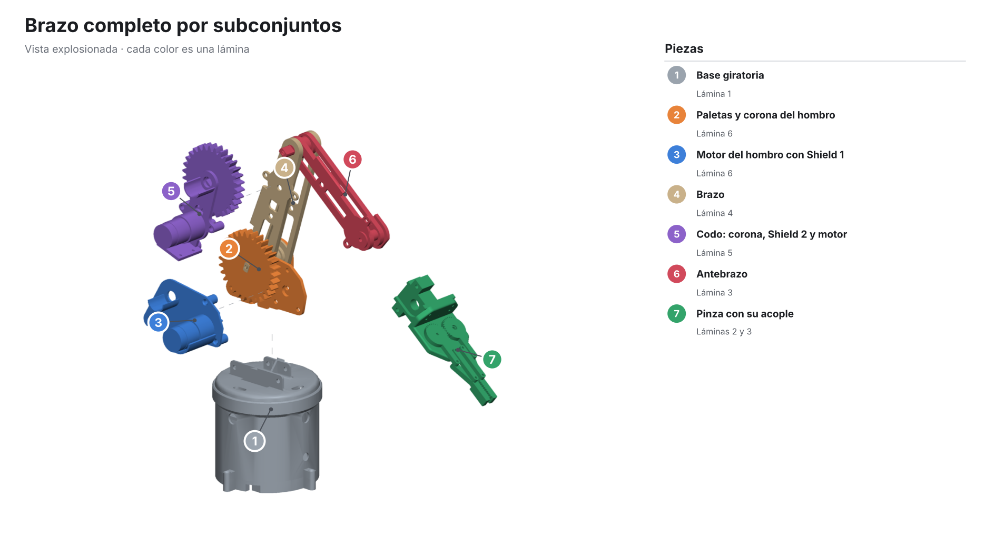
Gripper_Rapha/ENSAMBLAJE/explosionados/explosionado_0_brazo_completo.png
