rapha-gz-UC3M/Brazo_Robotico/Gripper_Rapha/ENSAMBLAJE/explosionados/explosionado_1_base.png

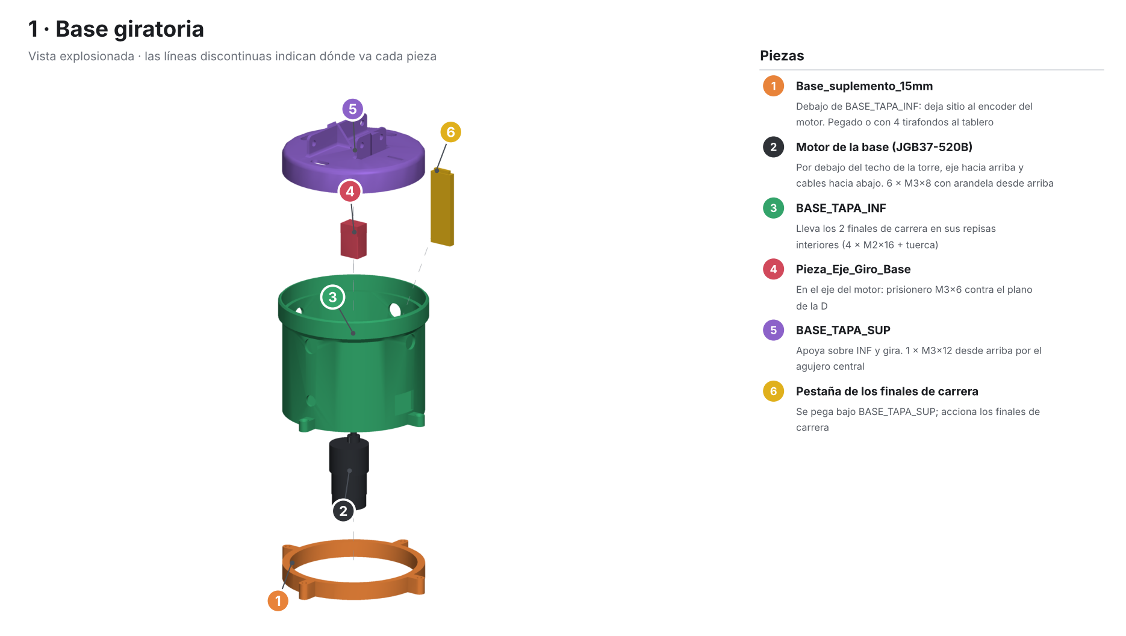
Gripper_Rapha/ENSAMBLAJE/explosionados/explosionado_1_base.png
