rapha-gz-UC3M/Brazo_Robotico/Gripper_Rapha/ENSAMBLAJE/explosionados/explosionado_2_gripper.png

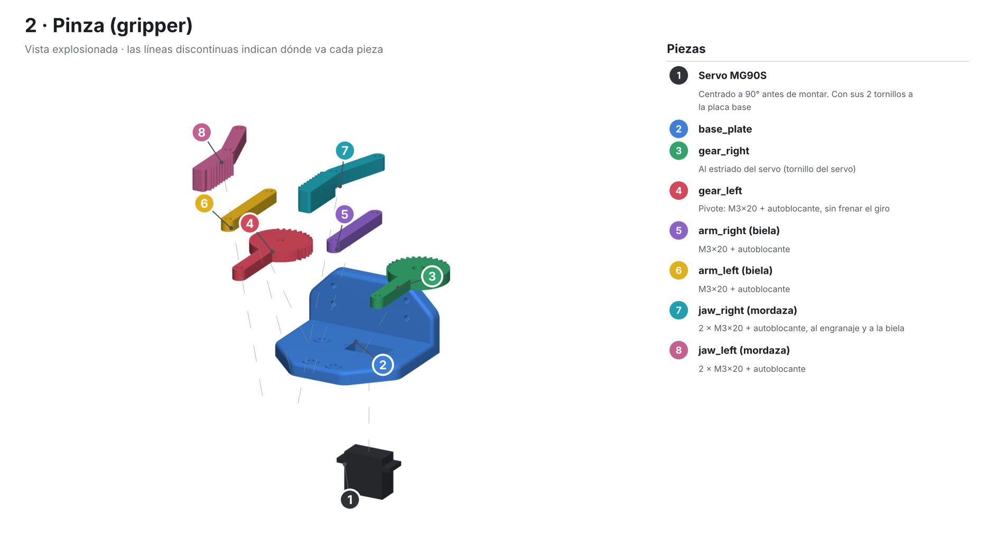
Gripper_Rapha/ENSAMBLAJE/explosionados/explosionado_2_gripper.png
