rapha-gz-UC3M/Brazo_Robotico/Gripper_Rapha/ENSAMBLAJE/explosionados/explosionado_3_antebrazo.png

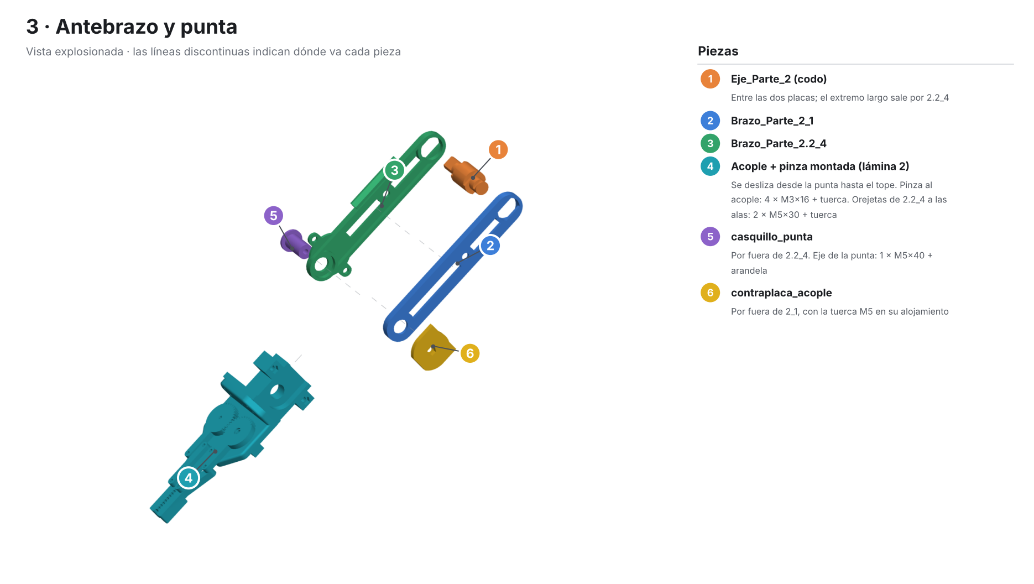
Gripper_Rapha/ENSAMBLAJE/explosionados/explosionado_3_antebrazo.png
