rapha-gz-UC3M/Brazo_Robotico/Gripper_Rapha/ENSAMBLAJE/explosionados/explosionado_4_brazo.png

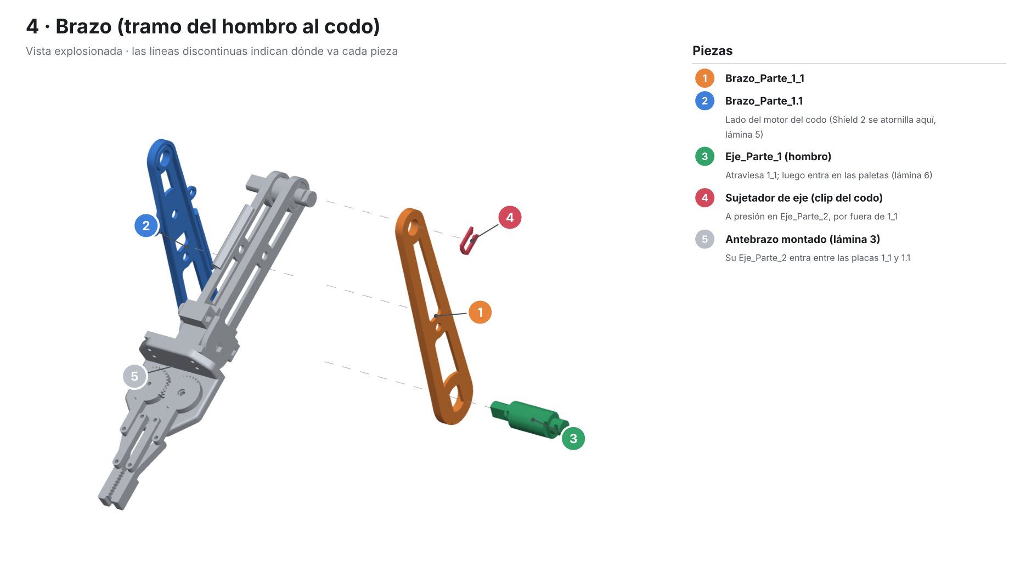
Gripper_Rapha/ENSAMBLAJE/explosionados/explosionado_4_brazo.png
