rapha-gz-UC3M/Brazo_Robotico/Gripper_Rapha/ENSAMBLAJE/explosionados/explosionado_5_codo.png

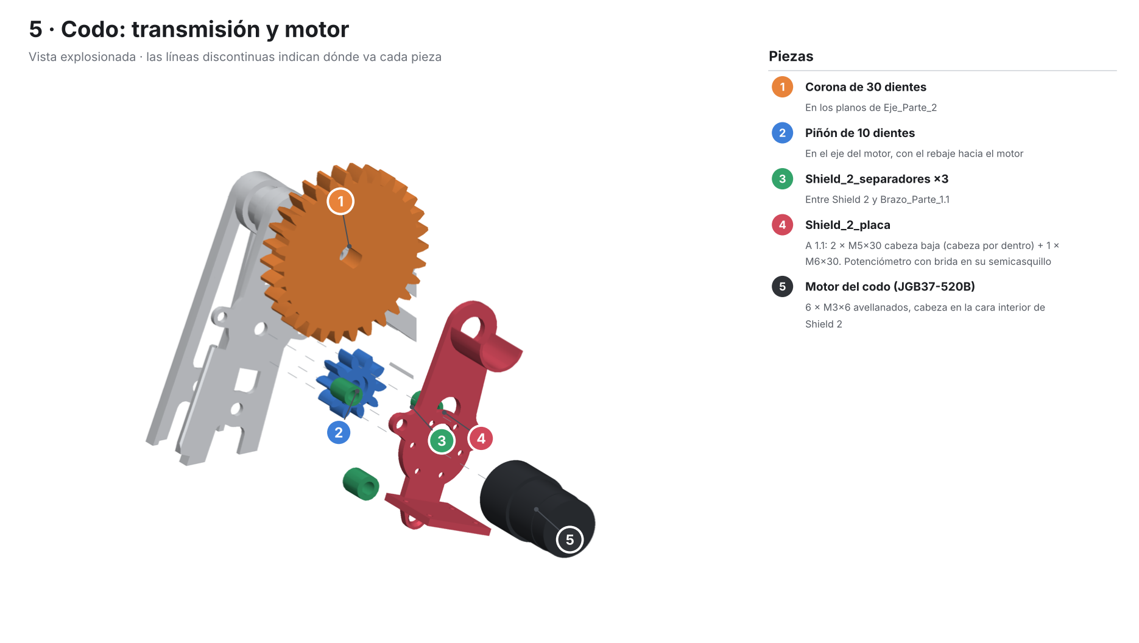
Gripper_Rapha/ENSAMBLAJE/explosionados/explosionado_5_codo.png
