rapha-gz-UC3M/Brazo_Robotico/Gripper_Rapha/ENSAMBLAJE/explosionados/explosionado_6_hombro.png

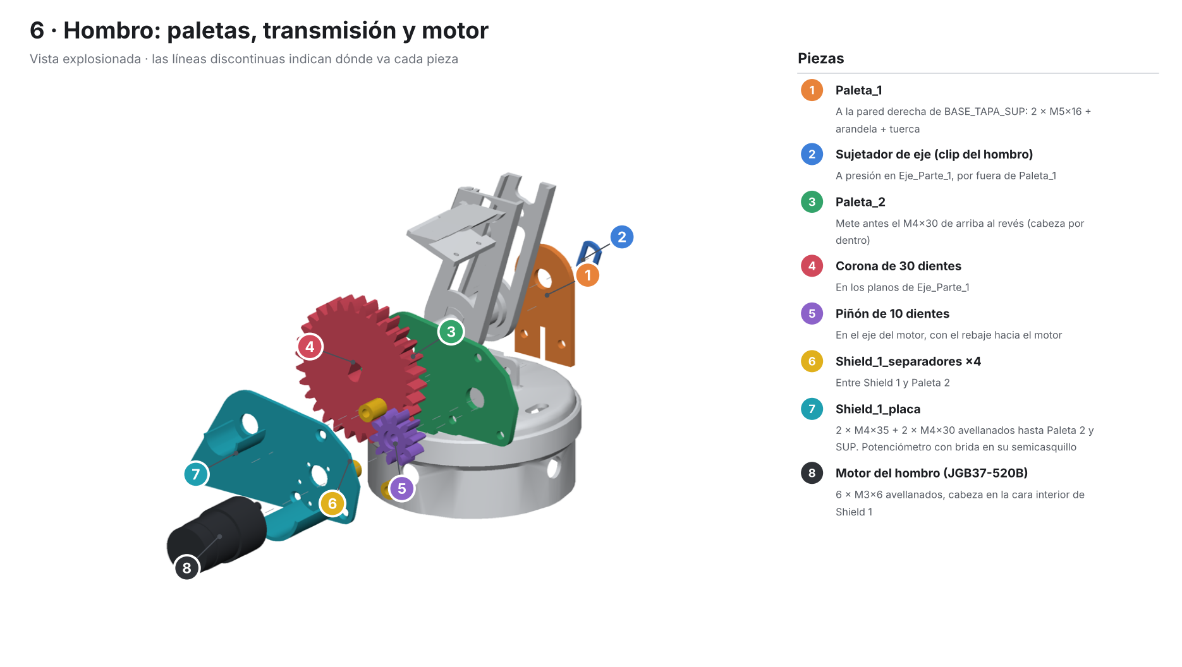
Gripper_Rapha/ENSAMBLAJE/explosionados/explosionado_6_hombro.png
