rapha-gz-UC3M/Brazo_Robotico/Gripper_Rapha/ensamblaje_completo/imagenes/ensamblaje_iso.png

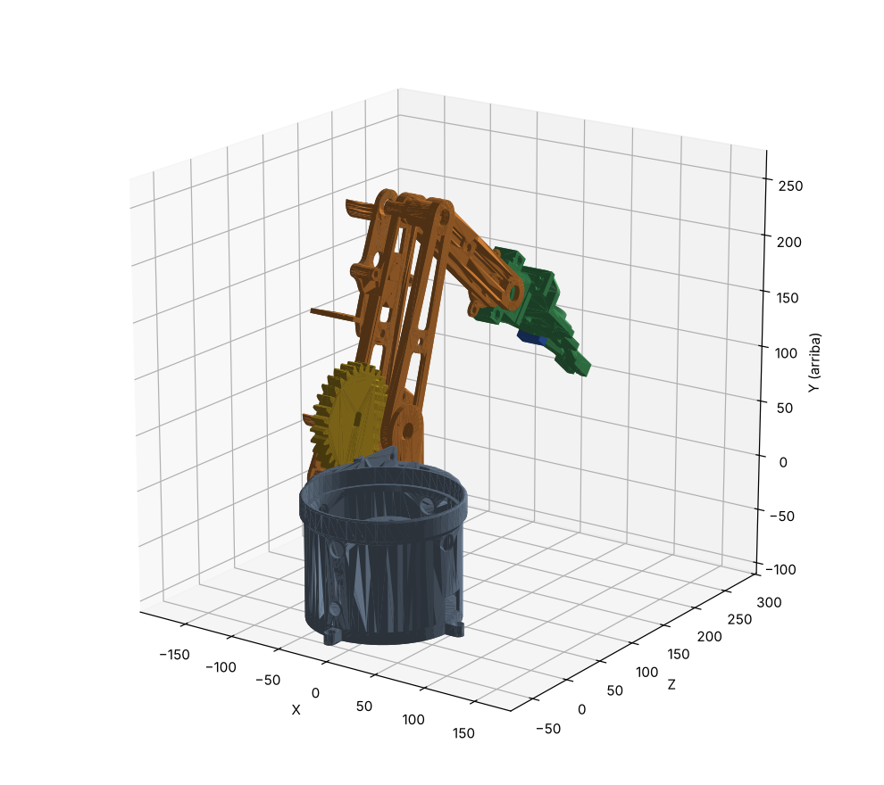
Gripper_Rapha/ensamblaje_completo/imagenes/ensamblaje_iso.png
