rapha-gz-UC3M/Brazo_Robotico/Gripper_Rapha/GRIPPER/imagenes/montaje_3d.png

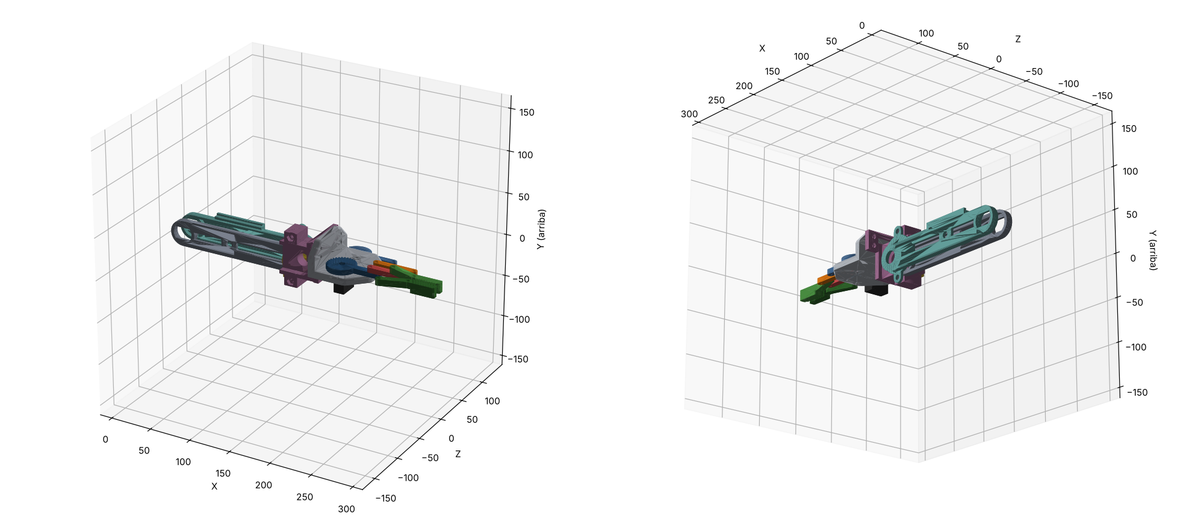
Gripper_Rapha/GRIPPER/imagenes/montaje_3d.png
