rapha-gz-UC3M/Brazo_Robotico/Gripper_Rapha/SOFTWARE/brazo_robotico/comandos.h

// comandos.h - Interfaz por el puerto serie (115200 baudios, fin de línea \n). Ver AYUDA o el README.
#pragma once
namespace Comandos {
  void leer();          // llamar en cada vuelta del loop
  void ayuda();
}
