rapha-gz-UC3M/Brazo_Robotico/(commit log)

2026-10-06 archivos
    temporales
    [BR3E - Base Tapa Inferior.STL, BR3E - Base Tapa Superior - Base.STL, BR3E - Base Tapa Superior - Entera.STL, BR3E - Base Tapa Superior - Paleta 1.STL, BR3E - Base Tapa Superior - Paleta 2.STL, BR3E - Brazo Parte 1.1.STL, BR3E - Brazo Parte 1.STL, BR3E - Brazo Parte 2.2.STL]
2026-10-17 Added CAD and STL base parts: Reorganized the repository
2026-10-17 Inferior Base Update: Motor Screws
2026-10-17 Final Commit for Base Parts: Screw Holes where not centered
2026-10-18 Actualizacion Gripper y Acople a brazo Vasil
2026-10-21 Gripper modificado
2026-10-21 escalado y ayuda de impresion
2026-11-12 Cambios de la tutoría: tabla de aglomerado, sin fusible ni convertidor del servo
    - Guía de cableado nueva en Gripper_Rapha/CABLEADO (esquemas, pines, comprobaciones)
    - Base atornillada a una tabla de aglomerado con 4 tirafondos Ø4 (TORNILLERIA.md)
    - Condensadores en lugar del fusible y del convertidor de 5 V del servo
    - READMEs actualizados
    Claude-Session: https://claude.ai/code/session_01V5KEVeeqc31KuXqZicNN1L
